I-want-to-make-more-forks-of-same-repo/MMS3_MCU_ESP32-C6/README.md

# MMS 3 ESP32 C6

## Project Status: **Ongoing**  
### Ver 1.0
**Design** ✅ — **Fabrication** ⏳ — **Assembly** ⏳ — **Bringup** ⏳ — **Testing** ⏳

Jak za 3 razem się udało, to za 4 też będzie git!

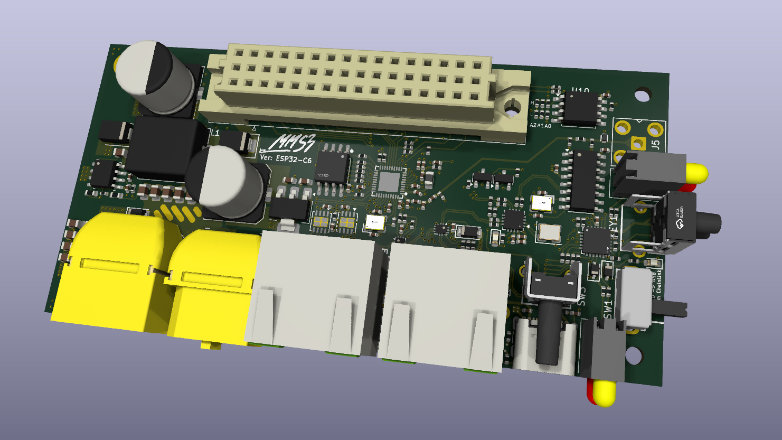
[picture p1: PCB_Picture.png]
Zdjęcie płytki
