I-want-to-make-more-forks-of-same-repo/MMS3_MCU_ESP32-C6/MMS3/MMS3_ESP32-C6.kicad_pcb

## KiCad design MMS3/MMS3_ESP32-C6.kicad_pcb (2026-10-02)

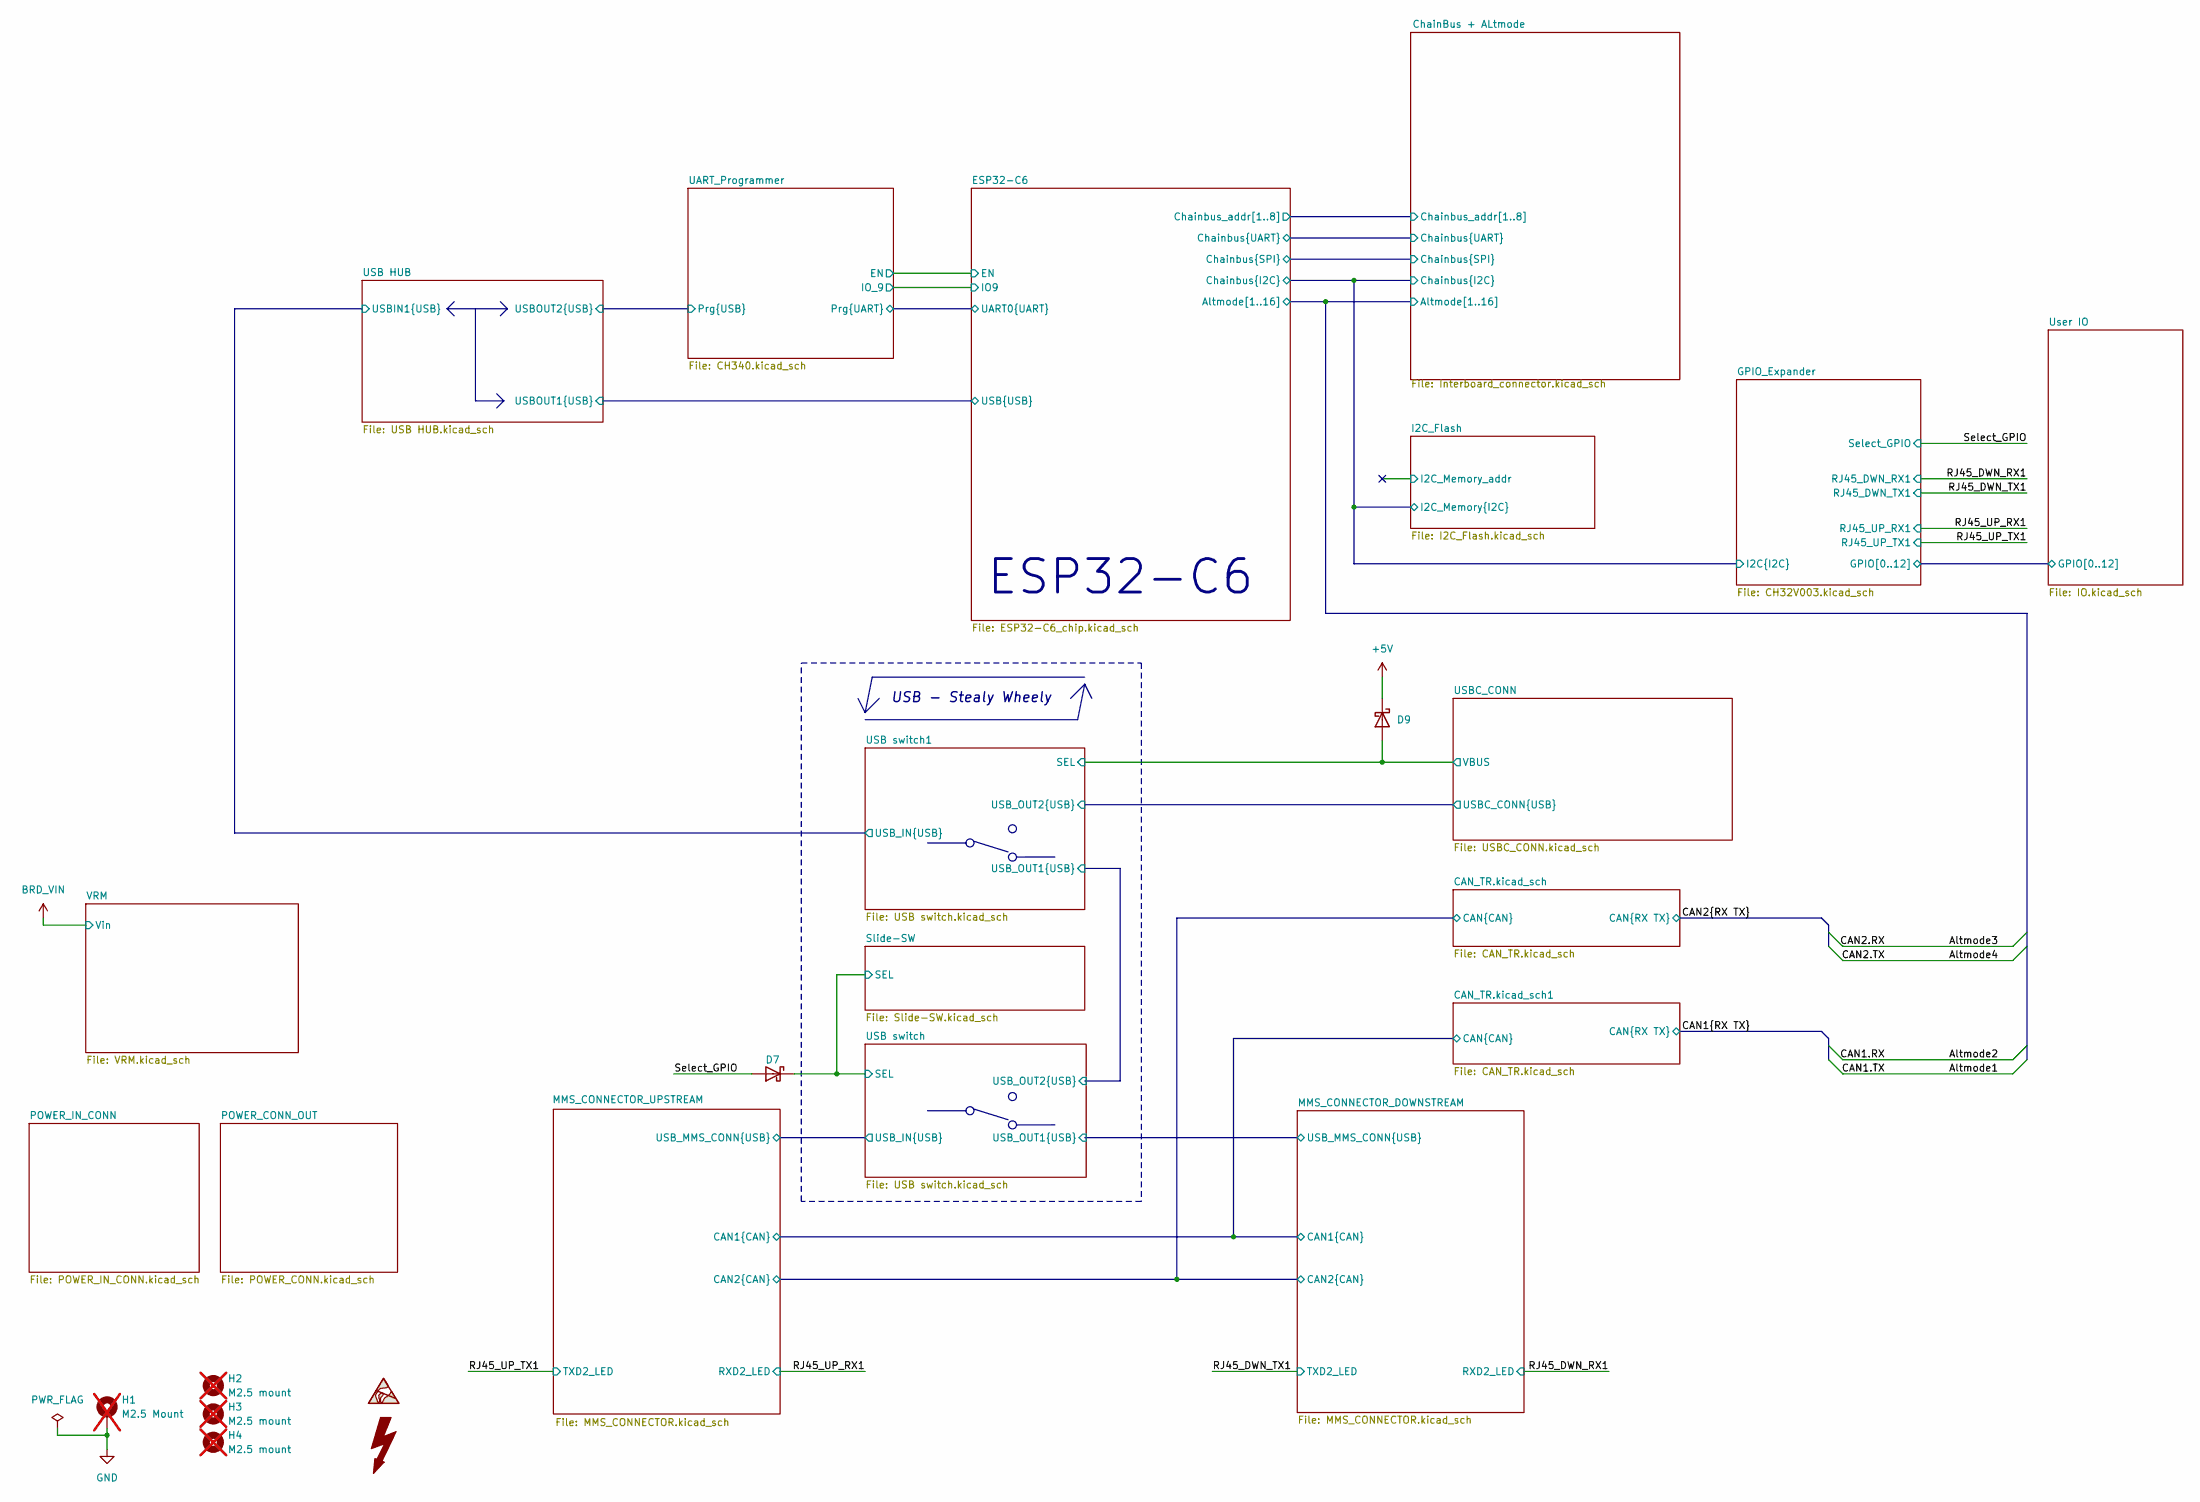
[picture p2: schematic MMS3_ESP32-C6.kicad_sch, MMS3 MCU ESP32-C6]

Parts:
D7, D9: 1N5819WS; D_SOD-323; Forward Voltage (Vf@If) 600mV@1A; Reverse Voltage (Vr) 40V; Part 1N5819WS; LCSC C191023
H1: M2.5 Mount; MountingHole_2.7mm_M2.5_DIN965_Pad_TopOnly; not fitted
H2, H3, H4: M2.5 mount; MountingHole_2.7mm_M2.5; not fitted

Connections:
+5V: D9.1; also elsewhere on the board
/Select_GPIO: D7.2; also elsewhere on the board
/Slide-SW/SEL: D7.1; also elsewhere on the board
/USBC_CONN/VBUS: D9.2; also elsewhere on the board
GND: H1.1 (1_1); also elsewhere on the board

Notes on the sheet:
USB - Stealy Wheely
ESP32-C6

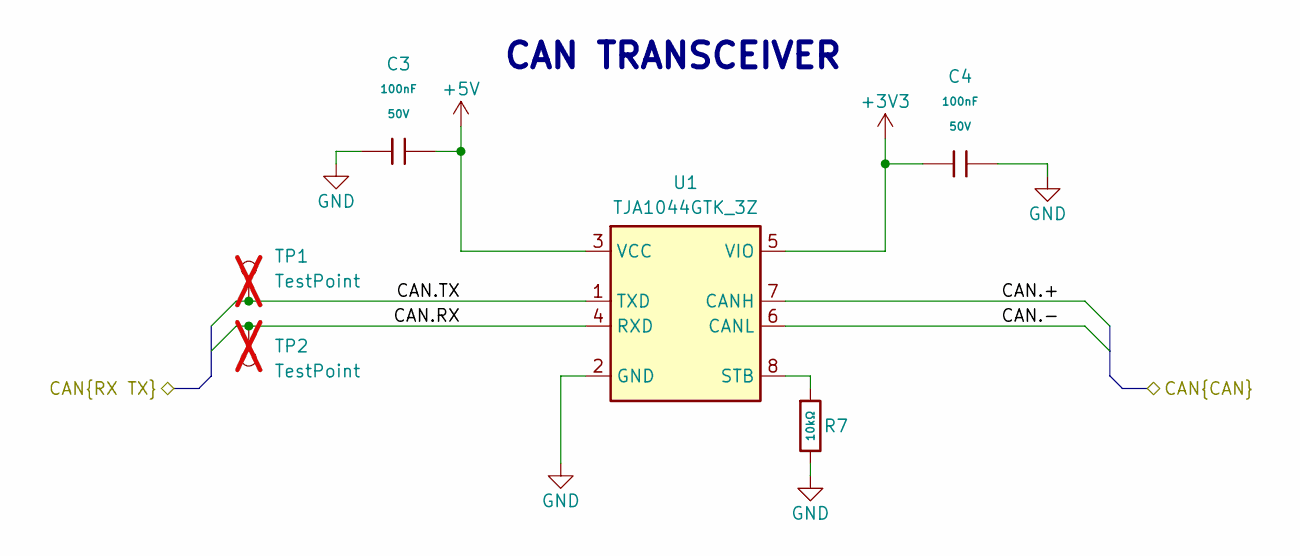
[picture p3: schematic CAN_TR.kicad_sch, MMS3 MCU ESP32-C6]

Parts:
C3, C4: 100nF; C_0402; Voltage Rated 50V; Tolerance ±10%; Part CL05B104KB54PNC; LCSC C307331
R7: 10kΩ; R_0402; Overload Voltage (Max) 50V; Tolerance ±1%; Part 0402WGF1002TCE; LCSC C25744
TP1, TP2: TestPoint; TestPoint_Pad_D1.0mm; not fitted
U1: TJA1044GTK_3Z; HVSON-8-1EP_3x3mm_P0.65mm_EP1.6x2.4mm; Manufacturer_Part_Number TJA1044GTK/3Z; LCSC C5215851

Connections:
+3V3: C4.1, U1.5 (VIO); also elsewhere on the board
+5V: C3.2, U1.3 (VCC); also elsewhere on the board
/CAN_TR.kicad_sch/CAN.+: U1.7 (CANH); also elsewhere on the board
/CAN_TR.kicad_sch/CAN.-: U1.6 (CANL); also elsewhere on the board
/ChainBus + ALtmode/Altmode3: TP2.1 (1_1), U1.4 (RXD); also elsewhere on the board
/ChainBus + ALtmode/Altmode4: TP1.1 (1_1), U1.1 (TXD); also elsewhere on the board
GND: C3.1, C4.2, R7.2, U1.2 (GND), U1.9 (EP); also elsewhere on the board
unnamed: R7.1, U1.8 (STB)

Parts of its further copies:
C6, C7: 100nF; C_0402; Voltage Rated 50V; Tolerance ±10%; Part CL05B104KB54PNC; LCSC C307331
R12: 10kΩ; R_0402; Overload Voltage (Max) 50V; Tolerance ±1%; Part 0402WGF1002TCE; LCSC C25744
TP3, TP4: TestPoint; TestPoint_Pad_D1.0mm; not fitted
U6: TJA1044GTK_3Z; HVSON-8-1EP_3x3mm_P0.65mm_EP1.6x2.4mm; Manufacturer_Part_Number TJA1044GTK/3Z; LCSC C5215851

Connections of its further copies:
+3V3: C7.1, U6.5 (VIO); also elsewhere on the board
+5V: C6.2, U6.3 (VCC); also elsewhere on the board
/CAN_TR.kicad_sch1/CAN.+: U6.7 (CANH); also elsewhere on the board
/CAN_TR.kicad_sch1/CAN.-: U6.6 (CANL); also elsewhere on the board
/ChainBus + ALtmode/Altmode1: TP3.1 (1_1), U6.1 (TXD); also elsewhere on the board
/ChainBus + ALtmode/Altmode2: TP4.1 (1_1), U6.4 (RXD); also elsewhere on the board
GND: C6.1, C7.2, R12.2, U6.2 (GND), U6.9 (EP); also elsewhere on the board
unnamed: R12.1, U6.8 (STB)

Notes on the sheet:
CAN TRANSCEIVER

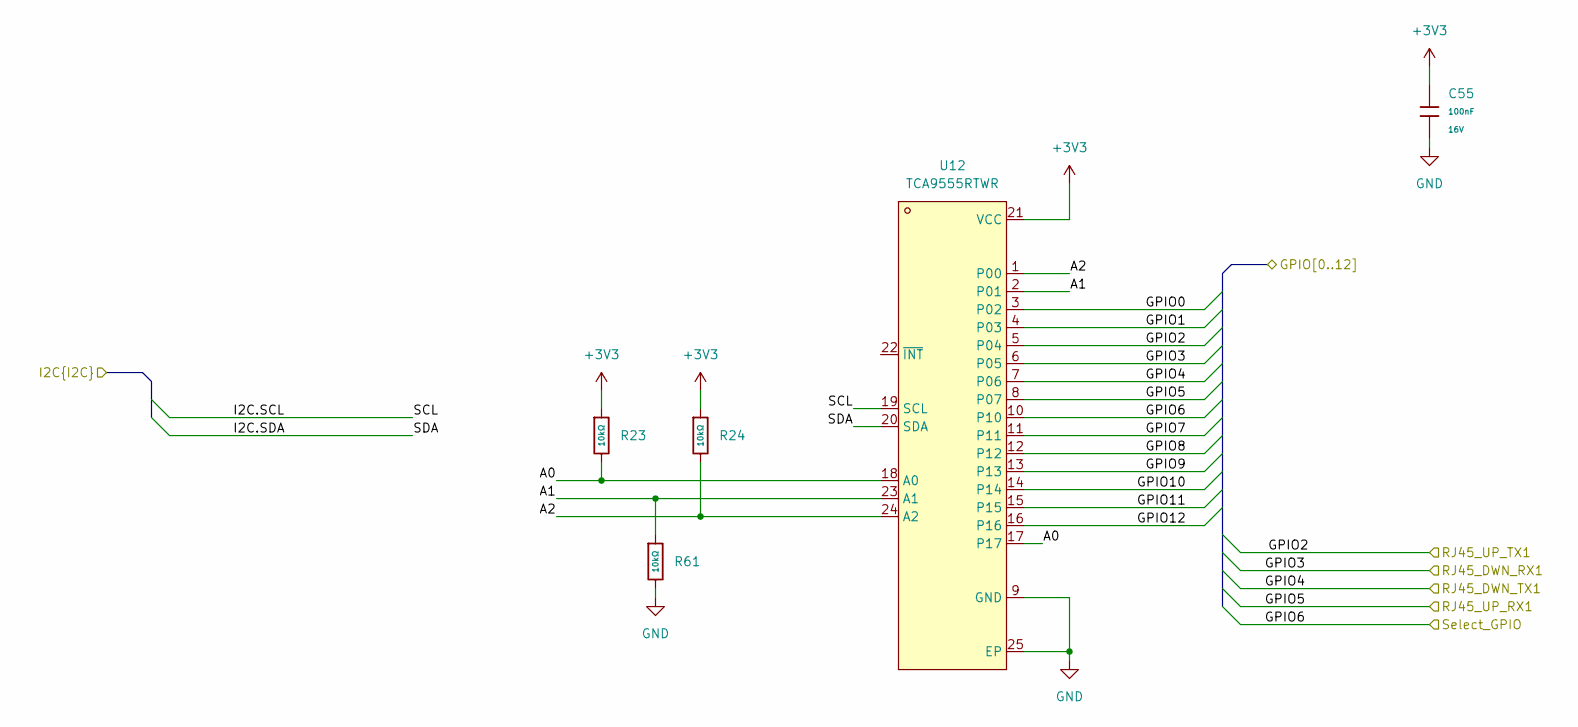
[picture p4: schematic CH32V003.kicad_sch, MMS3 Hat Meter/Source]

Parts:
C55: 100nF; C_0402; Voltage Rated 16V; Tolerance ±10%; Part CL05B104KO5NNNC; LCSC C1525
R23, R24, R61: 10kΩ; R_0402; Overload Voltage (Max) 50V; Tolerance ±1%; Part 0402WGF1002TCE; LCSC C25744
U12: TCA9555RTWR; HVQFN-24_L4.0-W4.0-P0.50-BL-EP2.6; MPN TCA9555RTWR(UMW); LCSC Part C42420609

Connections:
+3V3: C55.1, R23.1, R24.1, U12.21 (VCC); also elsewhere on the board
/ChainBus + ALtmode/Chainbus.SCL: U12.19 (SCL); also elsewhere on the board
/ChainBus + ALtmode/Chainbus.SDA: U12.20 (SDA); also elsewhere on the board
/GPIO_Expander/A0: R23.2, U12.17, U12.18 (A0)
/GPIO_Expander/A1: R61.1, U12.2 (P01), U12.23 (A1)
/GPIO_Expander/A2: R24.2, U12.1 (P00), U12.24 (A2)
/GPIO_Expander/GPIO0: U12.3 (P02); also elsewhere on the board
/GPIO_Expander/GPIO1: U12.4 (P03); also elsewhere on the board
/GPIO_Expander/GPIO7: U12.11
/GPIO_Expander/GPIO8: U12.12; also elsewhere on the board
/GPIO_Expander/GPIO9: U12.13; also elsewhere on the board
/GPIO_Expander/GPIO10: U12.14; also elsewhere on the board
/GPIO_Expander/GPIO11: U12.15
/GPIO_Expander/GPIO12: U12.16
/RJ45_DWN_RX1: U12.6 (P05); also elsewhere on the board
/RJ45_DWN_TX1: U12.7 (P06); also elsewhere on the board
/RJ45_UP_RX1: U12.8 (P07); also elsewhere on the board
/RJ45_UP_TX1: U12.5 (P04); also elsewhere on the board
/Select_GPIO: U12.10; also elsewhere on the board
GND: C55.2, R61.2, U12.9 (GND), U12.25 (EP); also elsewhere on the board

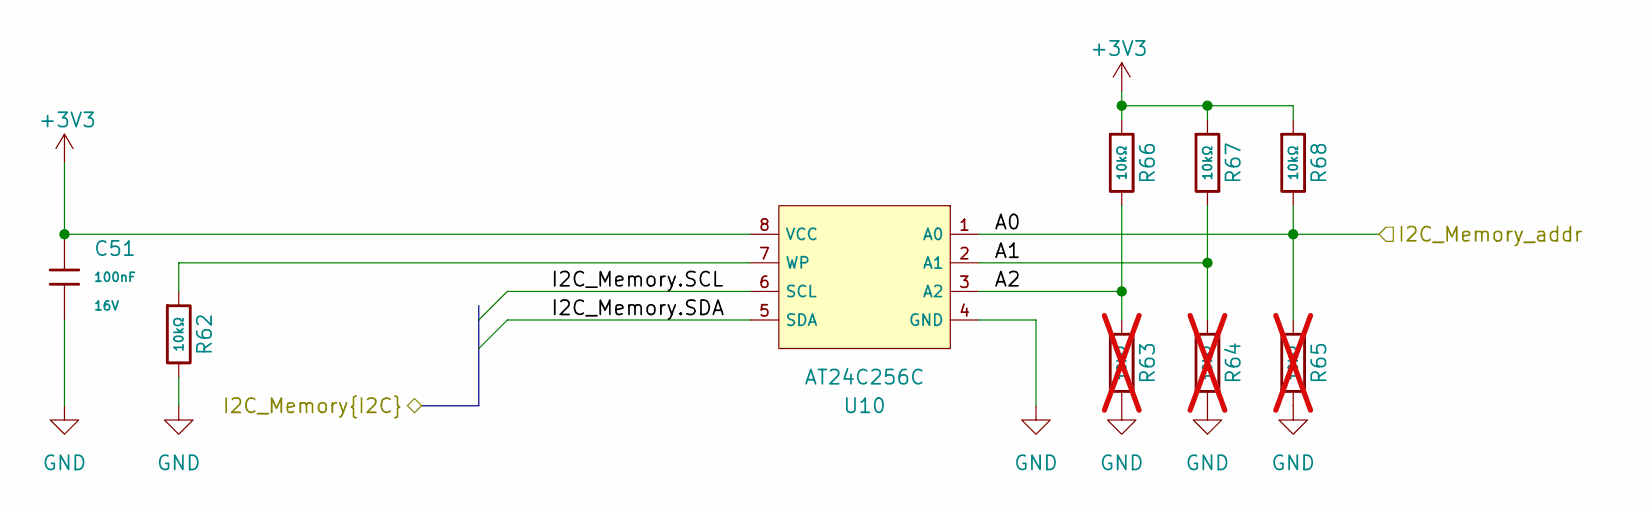
[picture p5: schematic I2C_Flash.kicad_sch, MMS3 MCU ESP32-C6]

Parts:
C51: 100nF; C_0402; Voltage Rated 16V; Tolerance ±10%; Part CL05B104KO5NNNC; LCSC C1525
R62, R66, R67, R68: 10kΩ; R_0402; Overload Voltage (Max) 50V; Tolerance ±1%; Part 0402WGF1002TCE; LCSC C25744
R63, R64, R65: 10kΩ; R_0402; Overload Voltage (Max) 50V; Tolerance ±1%; Part 0402WGF1002TCE; LCSC C25744; not fitted
U10: AT24C256C; SOIC-8_5.3x5.3mm_P1.27mm; Supply Voltage 1.7V~5.5V; Part AT24C256C-SSHL-T; LCSC C6482

Connections:
+3V3: C51.1, R66.1, R67.1, R68.1, U10.8 (VCC); also elsewhere on the board
/ChainBus + ALtmode/Chainbus.SCL: U10.6 (SCL); also elsewhere on the board
/ChainBus + ALtmode/Chainbus.SDA: U10.5 (SDA); also elsewhere on the board
/I2C_Flash/A0: R65.1, R68.2, U10.1 (A0)
/I2C_Flash/A1: R64.1, R67.2, U10.2 (A1)
/I2C_Flash/A2: R63.1, R66.2, U10.3 (A2)
GND: C51.2, R62.2, R63.2, R64.2, R65.2, U10.4 (GND); also elsewhere on the board
unnamed: R62.1, U10.7 (WP)

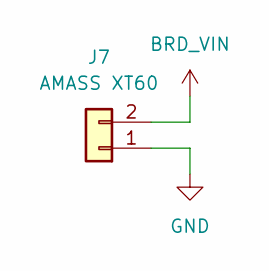
[picture p6: schematic POWER_CONN.kicad_sch, MMS3 MCU ESP32-C6]

Parts:
J7: AMASS XT60; AMASS_XT60PW-F_1x02_P7.20mm_Horizontal; LCSC C428722

Connections:
BRD_VIN: J7.2; also elsewhere on the board
GND: J7.1; also elsewhere on the board

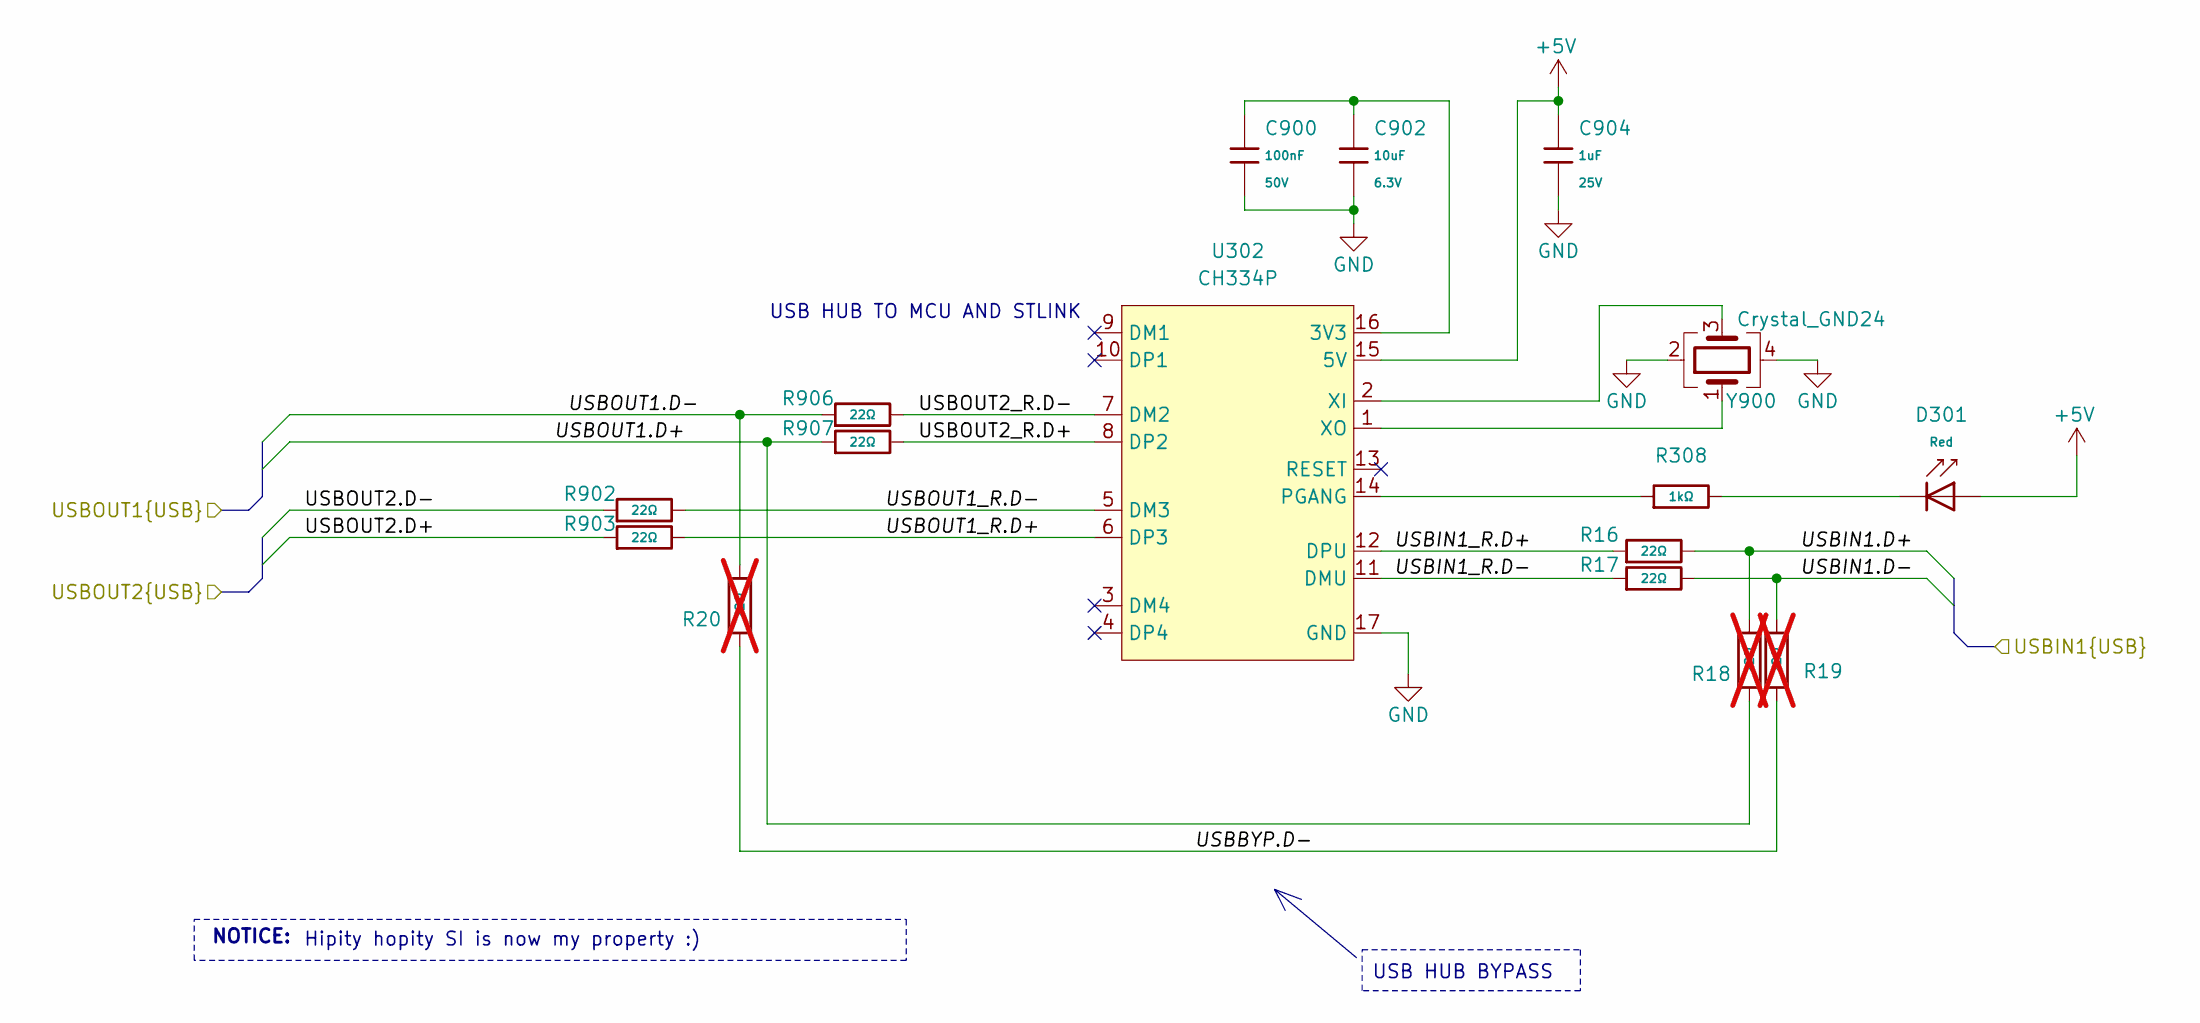
[picture p7: schematic USB HUB.kicad_sch, MMS3 MCU ESP32-C6]

Parts:
C900: 100nF; C_0402; Voltage Rated 50V; Tolerance ±10%; Part CL05B104KB54PNC; LCSC C307331
C902: 10uF; C_0402; Voltage Rated 6.3V; Tolerance ±20%; Part CL05A106MQ5NUNC; LCSC C15525
C904: 1uF; C_0402; Voltage Rated 25V; Tolerance ±10%; Part CL05A105KA5NQNC; LCSC C52923
D301: Red; D_0603; Part KT-0603R; LCSC C2286
R16, R17, R902, R903, R906, R907: 22Ω; R_0402; Overload Voltage (Max) 50V; Tolerance ±1%; Part 0402WGF220JTCE; LCSC C25092
R18, R19, R20: 22Ω; R_0402; Overload Voltage (Max) 50V; Tolerance ±1%; Part 0402WGF220JTCE; LCSC C25092; not fitted
R308: 1kΩ; R_0402; Overload Voltage (Max) 50V; Tolerance ±1%; Part 0402WGF1001TCE; LCSC C11702
U302: CH334P; QFN-16-1EP_3x3mm_P0.5mm_EP1.7x1.7mm; LCSC C5373042
Y900: Crystal_GND24; Crystal_SMD_3225-4Pin_3.2x2.5mm; LCSC C9002

Connections:
+5V: C904.1, D301.2, U302.15 (5V); also elsewhere on the board
/ESP32-C6/USB.D+: R18.1, R907.1; also elsewhere on the board
/ESP32-C6/USB.D-: R20.2, R906.1; also elsewhere on the board
/UART_Programmer/Prg.D+: R903.1; also elsewhere on the board
/UART_Programmer/Prg.D-: R902.1; also elsewhere on the board
/USB HUB/USBBYP.D-: R19.1, R20.1
/USB HUB/USBIN1.D+: R16.2, R18.2; also elsewhere on the board
/USB HUB/USBIN1.D-: R17.2, R19.2; also elsewhere on the board
/USB HUB/USBIN1_R.D+: R16.1, U302.12 (DPU)
/USB HUB/USBIN1_R.D-: R17.1, U302.11 (DMU)
/USB HUB/USBOUT1_R.D+: R903.2, U302.6 (DP3)
/USB HUB/USBOUT1_R.D-: R902.2, U302.5 (DM3)
/USB HUB/USBOUT2_R.D+: R907.2, U302.8 (DP2)
/USB HUB/USBOUT2_R.D-: R906.2, U302.7 (DM2)
GND: C900.2, C902.2, C904.2, U302.17 (GND), Y900.2, Y900.4; also elsewhere on the board
unnamed: D301.1, R308.2
unnamed: C900.1, C902.1, U302.16 (3V3)
unnamed: R308.1, U302.14 (PGANG)
unnamed: U302.2 (XI), Y900.3
unnamed: U302.1 (XO), Y900.1

Notes on the sheet:
NOTICE:
Hipity hopity SI is now my property :)
USB HUB TO MCU AND STLINK
USB HUB BYPASS

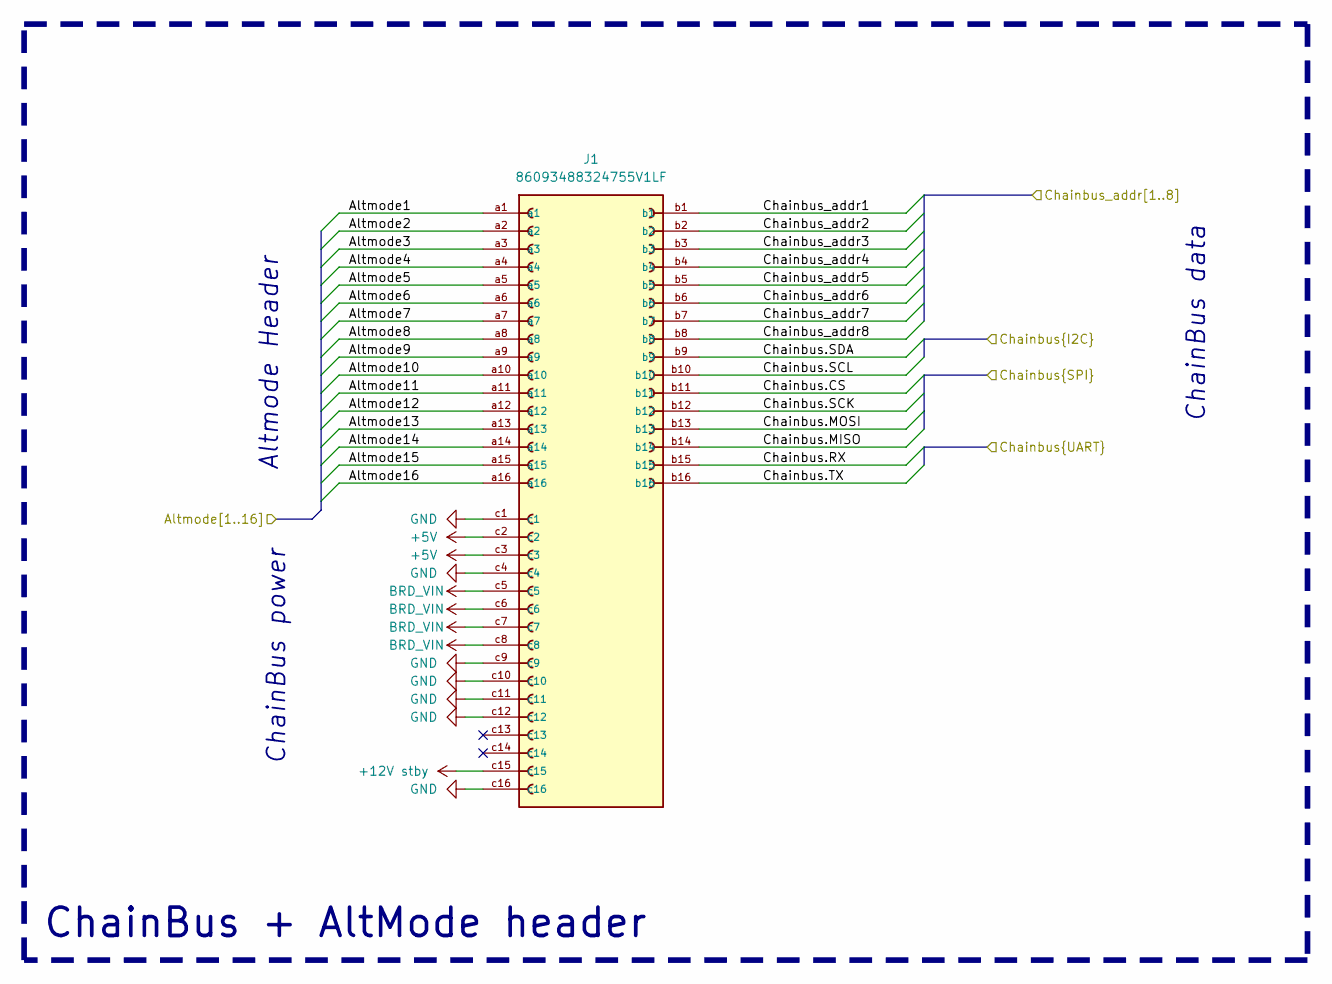
[picture p8: schematic Interboard_connector.kicad_sch, MMS3 MCU ESP32-C6]

Parts:
J1: 86093488324755V1LF; DIN41612_C2_3x16_Female_Vertical_THT; PARTREV C; LCSC C5173373

Connections:
+5V: J1.c2, J1.c3; also elsewhere on the board
+12V stby: J1.c15; also elsewhere on the board
/ChainBus + ALtmode/Altmode1: J1.a1; also elsewhere on the board
/ChainBus + ALtmode/Altmode2: J1.a2; also elsewhere on the board
/ChainBus + ALtmode/Altmode3: J1.a3; also elsewhere on the board
/ChainBus + ALtmode/Altmode4: J1.a4; also elsewhere on the board
/ChainBus + ALtmode/Altmode5: J1.a5
/ChainBus + ALtmode/Altmode6: J1.a6
/ChainBus + ALtmode/Altmode7: J1.a7
/ChainBus + ALtmode/Altmode8: J1.a8
/ChainBus + ALtmode/Altmode9: J1.a9
/ChainBus + ALtmode/Altmode10: J1.a10
/ChainBus + ALtmode/Altmode11: J1.a11
/ChainBus + ALtmode/Altmode12: J1.a12
/ChainBus + ALtmode/Altmode13: J1.a13
/ChainBus + ALtmode/Altmode14: J1.a14
/ChainBus + ALtmode/Altmode15: J1.a15
/ChainBus + ALtmode/Altmode16: J1.a16
/ChainBus + ALtmode/Chainbus.CS: J1.b11; also elsewhere on the board
/ChainBus + ALtmode/Chainbus.MISO: J1.b14; also elsewhere on the board
/ChainBus + ALtmode/Chainbus.MOSI: J1.b13; also elsewhere on the board
/ChainBus + ALtmode/Chainbus.RX: J1.b15; also elsewhere on the board
/ChainBus + ALtmode/Chainbus.SCK: J1.b12; also elsewhere on the board
/ChainBus + ALtmode/Chainbus.SCL: J1.b10; also elsewhere on the board
/ChainBus + ALtmode/Chainbus.SDA: J1.b9; also elsewhere on the board
/ChainBus + ALtmode/Chainbus.TX: J1.b16; also elsewhere on the board
/ChainBus + ALtmode/Chainbus_addr1: J1.b1; also elsewhere on the board
/ChainBus + ALtmode/Chainbus_addr2: J1.b2; also elsewhere on the board
/ChainBus + ALtmode/Chainbus_addr3: J1.b3; also elsewhere on the board
/ChainBus + ALtmode/Chainbus_addr4: J1.b4; also elsewhere on the board
/ChainBus + ALtmode/Chainbus_addr5: J1.b5; also elsewhere on the board
/ChainBus + ALtmode/Chainbus_addr6: J1.b6; also elsewhere on the board
/ChainBus + ALtmode/Chainbus_addr7: J1.b7; also elsewhere on the board
/ChainBus + ALtmode/Chainbus_addr8: J1.b8; also elsewhere on the board
BRD_VIN: J1.c5, J1.c6, J1.c7, J1.c8; also elsewhere on the board
GND: J1.c1, J1.c4, J1.c9, J1.c10, J1.c11, J1.c12, J1.c16; also elsewhere on the board

Notes on the sheet:
ChainBus data
ChainBus power
Altmode Header
ChainBus + AltMode header

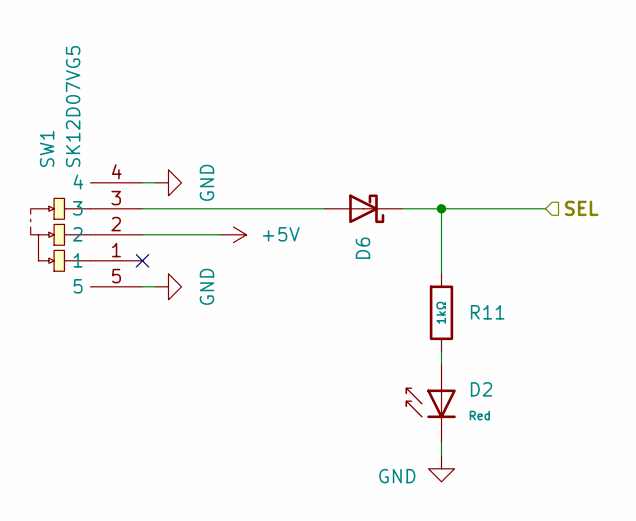
[picture p9: schematic Slide-SW.kicad_sch, MMS3 MCU ESP32-C6]

Parts:
D2: Red; D_0603; Part KT-0603R; LCSC C2286
D6: 1N5819WS; D_SOD-323; Forward Voltage (Vf@If) 600mV@1A; Reverse Voltage (Vr) 40V; Part 1N5819WS; LCSC C191023
R11: 1kΩ; R_0402; Overload Voltage (Max) 50V; Tolerance ±1%; Part 0402WGF1001TCE; LCSC C11702
SW1: SK12D07VG5; SW-TH_SK12D07VG5-1; MPN SK12D07VG5; LCSC Part C431548

Connections:
+5V: SW1.2; also elsewhere on the board
/Slide-SW/SEL: D6.1, R11.1; also elsewhere on the board
GND: D2.1, SW1.4, SW1.5; also elsewhere on the board
unnamed: D2.2, R11.2
unnamed: D6.2, SW1.3

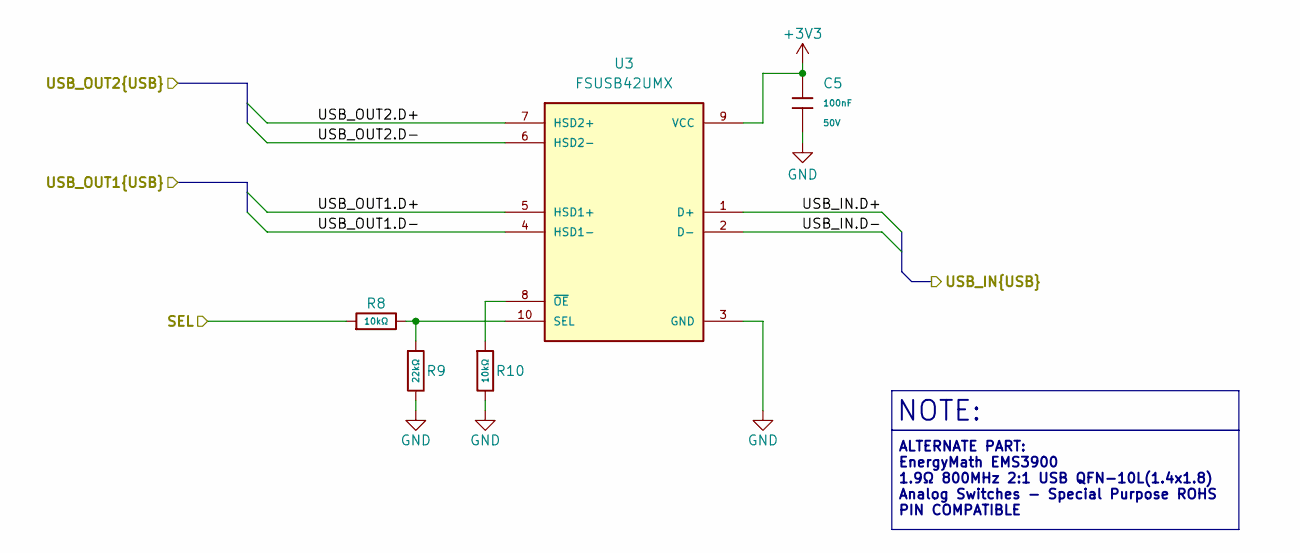
[picture p10: schematic USB switch.kicad_sch, MMS3 MCU ESP32-C6]

Parts:
C5: 100nF; C_0402; Voltage Rated 50V; Tolerance ±10%; Part CL05B104KB54PNC; LCSC C307331
R8, R10: 10kΩ; R_0402; Overload Voltage (Max) 50V; Tolerance ±1%; Part 0402WGF1002TCE; LCSC C25744
R9: 22kΩ; R_0402; Overload Voltage (Max) 50V; Tolerance ±1%; Part 0402WGF2202TCE; LCSC C25768
U3: FSUSB42UMX; UQFN-10_1.4x1.8mm_P0.4mm; PARTREV 1.25; LCSC C11145

Connections:
+3V3: C5.1, U3.9 (VCC); also elsewhere on the board
/MMS_CONNECTOR_DOWNSTREAM/USB_MMS_CONN.D+: U3.5 (HSD1+); also elsewhere on the board
/MMS_CONNECTOR_DOWNSTREAM/USB_MMS_CONN.D-: U3.4 (HSD1-); also elsewhere on the board
/MMS_CONNECTOR_UPSTREAM/USB_MMS_CONN.D+: U3.1 (D+); also elsewhere on the board
/MMS_CONNECTOR_UPSTREAM/USB_MMS_CONN.D-: U3.2 (D-); also elsewhere on the board
/Slide-SW/SEL: R8.1; also elsewhere on the board
/USB switch/USB_OUT2.D+: U3.7 (HSD2+); also elsewhere on the board
/USB switch/USB_OUT2.D-: U3.6 (HSD2-); also elsewhere on the board
GND: C5.2, R9.2, R10.2, U3.3 (GND); also elsewhere on the board
unnamed: R8.2, R9.1, U3.10 (SEL)
unnamed: R10.1, U3.8 (~OE)

Parts of its further copies:
C8: 100nF; C_0402; Voltage Rated 50V; Tolerance ±10%; Part CL05B104KB54PNC; LCSC C307331
R13, R15: 10kΩ; R_0402; Overload Voltage (Max) 50V; Tolerance ±1%; Part 0402WGF1002TCE; LCSC C25744
R14: 22kΩ; R_0402; Overload Voltage (Max) 50V; Tolerance ±1%; Part 0402WGF2202TCE; LCSC C25768
U7: FSUSB42UMX; UQFN-10_1.4x1.8mm_P0.4mm; PARTREV 1.25; LCSC C11145

Connections of its further copies:
+3V3: C8.1, U7.9 (VCC); also elsewhere on the board
/USB HUB/USBIN1.D+: U7.1 (D+); also elsewhere on the board
/USB HUB/USBIN1.D-: U7.2 (D-); also elsewhere on the board
/USB switch1/USB_OUT2.D+: U7.7 (HSD2+); also elsewhere on the board
/USB switch1/USB_OUT2.D-: U7.6 (HSD2-); also elsewhere on the board
/USB switch/USB_OUT2.D+: U7.5 (HSD1+); also elsewhere on the board
/USB switch/USB_OUT2.D-: U7.4 (HSD1-); also elsewhere on the board
/USBC_CONN/VBUS: R13.1; also elsewhere on the board
GND: C8.2, R14.2, R15.2, U7.3 (GND); also elsewhere on the board
unnamed: R13.2, R14.1, U7.10 (SEL)
unnamed: R15.1, U7.8 (~OE)

Notes on the sheet:
ALTERNATE PART: EnergyMath EMS3900 1.9Ω 800MHz 2:1 USB QFN-10L(1.4x1.8) Analog Switches - Special Purpose ROHS PIN COMPATIBLE
NOTE:

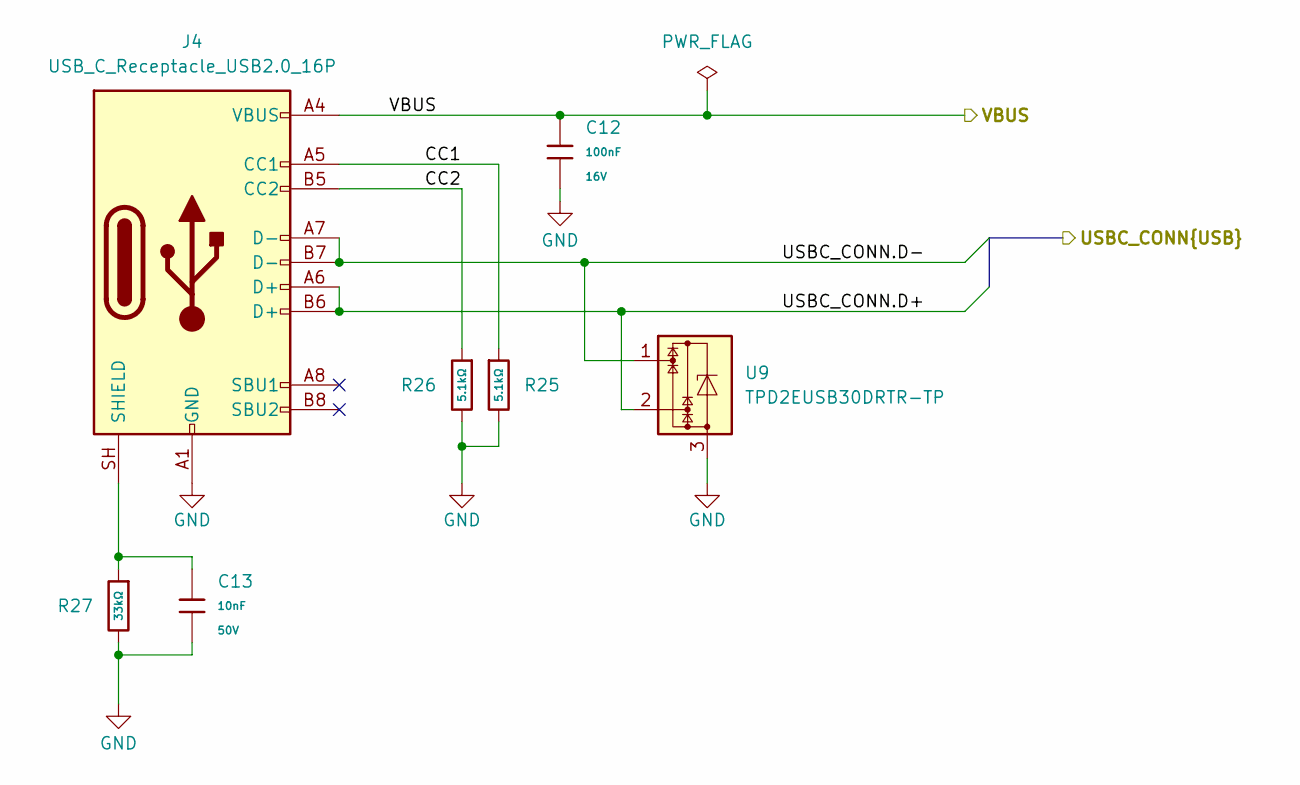
[picture p11: schematic USBC_CONN.kicad_sch, MMS3 MCU ESP32-C6]

Parts:
C12: 100nF; C_0402; Voltage Rated 16V; Tolerance ±10%; Part CL05B104KO5NNNC; LCSC C1525
C13: 10nF; C_0402; Voltage Rated 50V; Tolerance ±10%; Part CL05B103KB5NNNC; LCSC C15195
J4: USB_C_Receptacle_USB2.0_16P; USB_C_Receptacle_GCT_USB4105-xx-A_16P_TopMnt_Horizontal; LCSC C165948
R25, R26: 5.1kΩ; R_0402; Overload Voltage (Max) 50V; Tolerance ±1%; Part 0402WGF5101TCE; LCSC C25905
R27: 33kΩ; R_0402; Overload Voltage (Max) 50V; Tolerance ±1%; Part 0402WGF3302TCE; LCSC C25779
U9: TPD2EUSB30DRTR-TP; SOT-723; LCSC C2844720

Connections:
/USB switch1/USB_OUT2.D+: J4.A6 (D+), J4.B6 (D+), U9.2; also elsewhere on the board
/USB switch1/USB_OUT2.D-: J4.A7 (D-), J4.B7 (D-), U9.1; also elsewhere on the board
/USBC_CONN/CC1: J4.A5 (CC1), R25.1
/USBC_CONN/CC2: J4.B5 (CC2), R26.1
/USBC_CONN/VBUS: C12.1, J4.A4 (VBUS), J4.A9 (VBUS), J4.B4 (VBUS), J4.B9 (VBUS); also elsewhere on the board
GND: C12.2, C13.2, J4.A1 (GND), J4.A12 (GND), J4.B1 (GND), J4.B12 (GND), R25.2, R26.2, R27.2, U9.3; also elsewhere on the board
unnamed: C13.1, J4.SH (SHIELD), R27.1

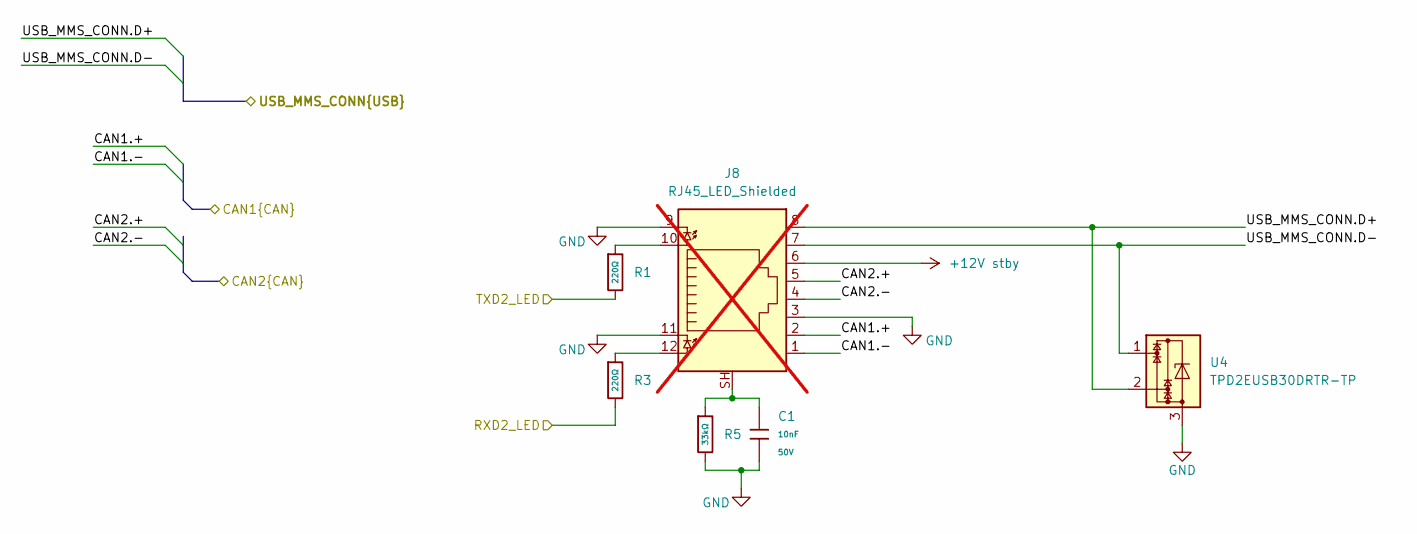
[picture p12: schematic MMS_CONNECTOR.kicad_sch, MMS3 MCU ESP32-C6]

Parts:
C1: 10nF; C_0402; Voltage Rated 50V; Tolerance ±10%; Part CL05B103KB5NNNC; LCSC C15195
J8: RJ45_LED_Shielded; RJ45_Amphenol_RJHSE538X; LCSC C7501824; not fitted
R1, R3: 220Ω; R_0402; Overload Voltage (Max) 50V; Tolerance ±1%; Part 0402WGF2200TCE; LCSC C25091
R5: 33kΩ; R_0402; Overload Voltage (Max) 50V; Tolerance ±1%; Part 0402WGF3302TCE; LCSC C25779
U4: TPD2EUSB30DRTR-TP; SOT-723; LCSC C2844720

Connections:
+12V stby: J8.6; also elsewhere on the board
/CAN_TR.kicad_sch1/CAN.+: J8.2; also elsewhere on the board
/CAN_TR.kicad_sch1/CAN.-: J8.1; also elsewhere on the board
/CAN_TR.kicad_sch/CAN.+: J8.5; also elsewhere on the board
/CAN_TR.kicad_sch/CAN.-: J8.4; also elsewhere on the board
/MMS_CONNECTOR_DOWNSTREAM/USB_MMS_CONN.D+: J8.8, U4.2; also elsewhere on the board
/MMS_CONNECTOR_DOWNSTREAM/USB_MMS_CONN.D-: J8.7, U4.1; also elsewhere on the board
/RJ45_DWN_RX1: R3.2; also elsewhere on the board
/RJ45_DWN_TX1: R1.2; also elsewhere on the board
GND: C1.2, J8.3, J8.9, J8.11, R5.2, U4.3; also elsewhere on the board
unnamed: C1.1, J8.SH, R5.1
unnamed: J8.10, R1.1
unnamed: J8.12, R3.1

Parts of its further copies:
C2: 10nF; C_0402; Voltage Rated 50V; Tolerance ±10%; Part CL05B103KB5NNNC; LCSC C15195
J9: RJ45_LED_Shielded; RJ45_Amphenol_RJHSE538X; LCSC C7501824; not fitted
R2, R4: 220Ω; R_0402; Overload Voltage (Max) 50V; Tolerance ±1%; Part 0402WGF2200TCE; LCSC C25091
R6: 33kΩ; R_0402; Overload Voltage (Max) 50V; Tolerance ±1%; Part 0402WGF3302TCE; LCSC C25779
U5: TPD2EUSB30DRTR-TP; SOT-723; LCSC C2844720

Connections of its further copies:
+12V stby: J9.6; also elsewhere on the board
/CAN_TR.kicad_sch1/CAN.+: J9.2; also elsewhere on the board
/CAN_TR.kicad_sch1/CAN.-: J9.1; also elsewhere on the board
/CAN_TR.kicad_sch/CAN.+: J9.5; also elsewhere on the board
/CAN_TR.kicad_sch/CAN.-: J9.4; also elsewhere on the board
/MMS_CONNECTOR_UPSTREAM/USB_MMS_CONN.D+: J9.8, U5.2; also elsewhere on the board
/MMS_CONNECTOR_UPSTREAM/USB_MMS_CONN.D-: J9.7, U5.1; also elsewhere on the board
/RJ45_UP_RX1: R4.2; also elsewhere on the board
/RJ45_UP_TX1: R2.2; also elsewhere on the board
GND: C2.2, J9.3, J9.9, J9.11, R6.2, U5.3; also elsewhere on the board
unnamed: C2.1, J9.SH, R6.1
unnamed: J9.10, R2.1
unnamed: J9.12, R4.1
