I-want-to-make-more-forks-of-same-repo/MMS3_MCU_ESP32-C6/MMS3/MMS3_ESP32-C6.kicad_pcb

## KiCad design MMS3/MMS3_ESP32-C6.kicad_pcb (continued)

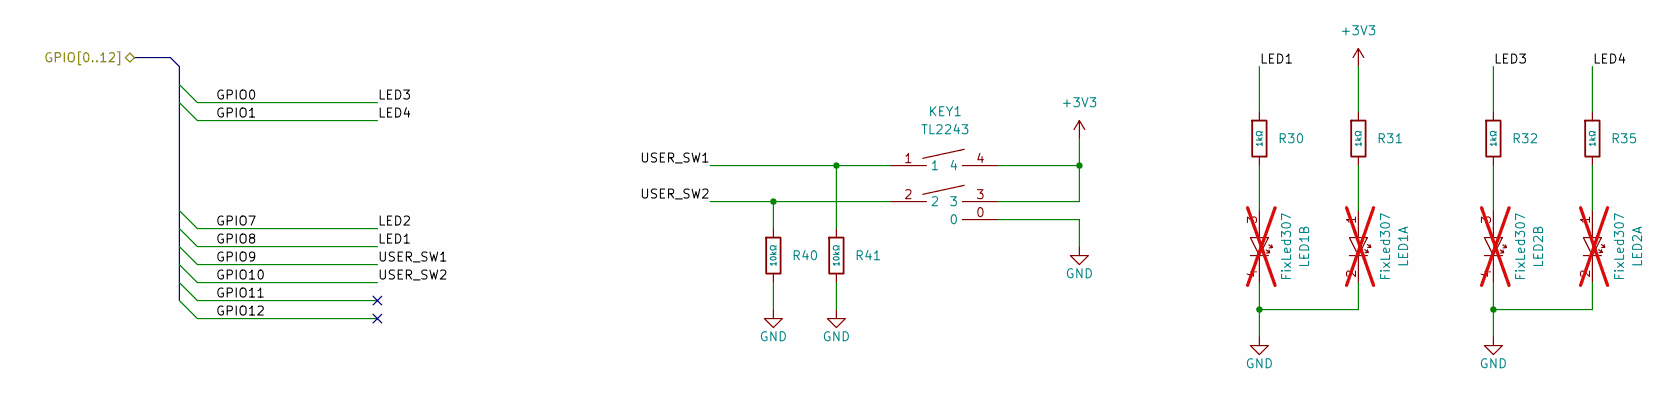
[picture p13: schematic IO.kicad_sch]

Parts:
KEY1: TL2243; KEY-TH_TL2243; MPN TL2243; LCSC Part C273515
LED1, LED2: FixLed307; not fitted
R30, R31, R32, R35: 1kΩ; R_0402; Overload Voltage (Max) 50V; Tolerance ±1%; Part 0402WGF1001TCE; LCSC C11702
R40, R41: 10kΩ; R_0402; Overload Voltage (Max) 50V; Tolerance ±1%; Part 0402WGF1002TCE; LCSC C25744

Connections:
+3V3: KEY1.3, KEY1.4, R31.1; also elsewhere on the board
/GPIO_Expander/GPIO0: R32.1; also elsewhere on the board
/GPIO_Expander/GPIO1: R35.1; also elsewhere on the board
/GPIO_Expander/GPIO8: R30.1; also elsewhere on the board
/GPIO_Expander/GPIO9: KEY1.1, R41.1; also elsewhere on the board
/GPIO_Expander/GPIO10: KEY1.2, R40.1; also elsewhere on the board
GND: KEY1.0, LED1.2, LED1.4, LED2.2, LED2.4, R40.2, R41.2; also elsewhere on the board
unnamed: LED1.1, R31.2
unnamed: LED1.3, R30.2
unnamed: LED2.1, R35.2
unnamed: LED2.3, R32.2

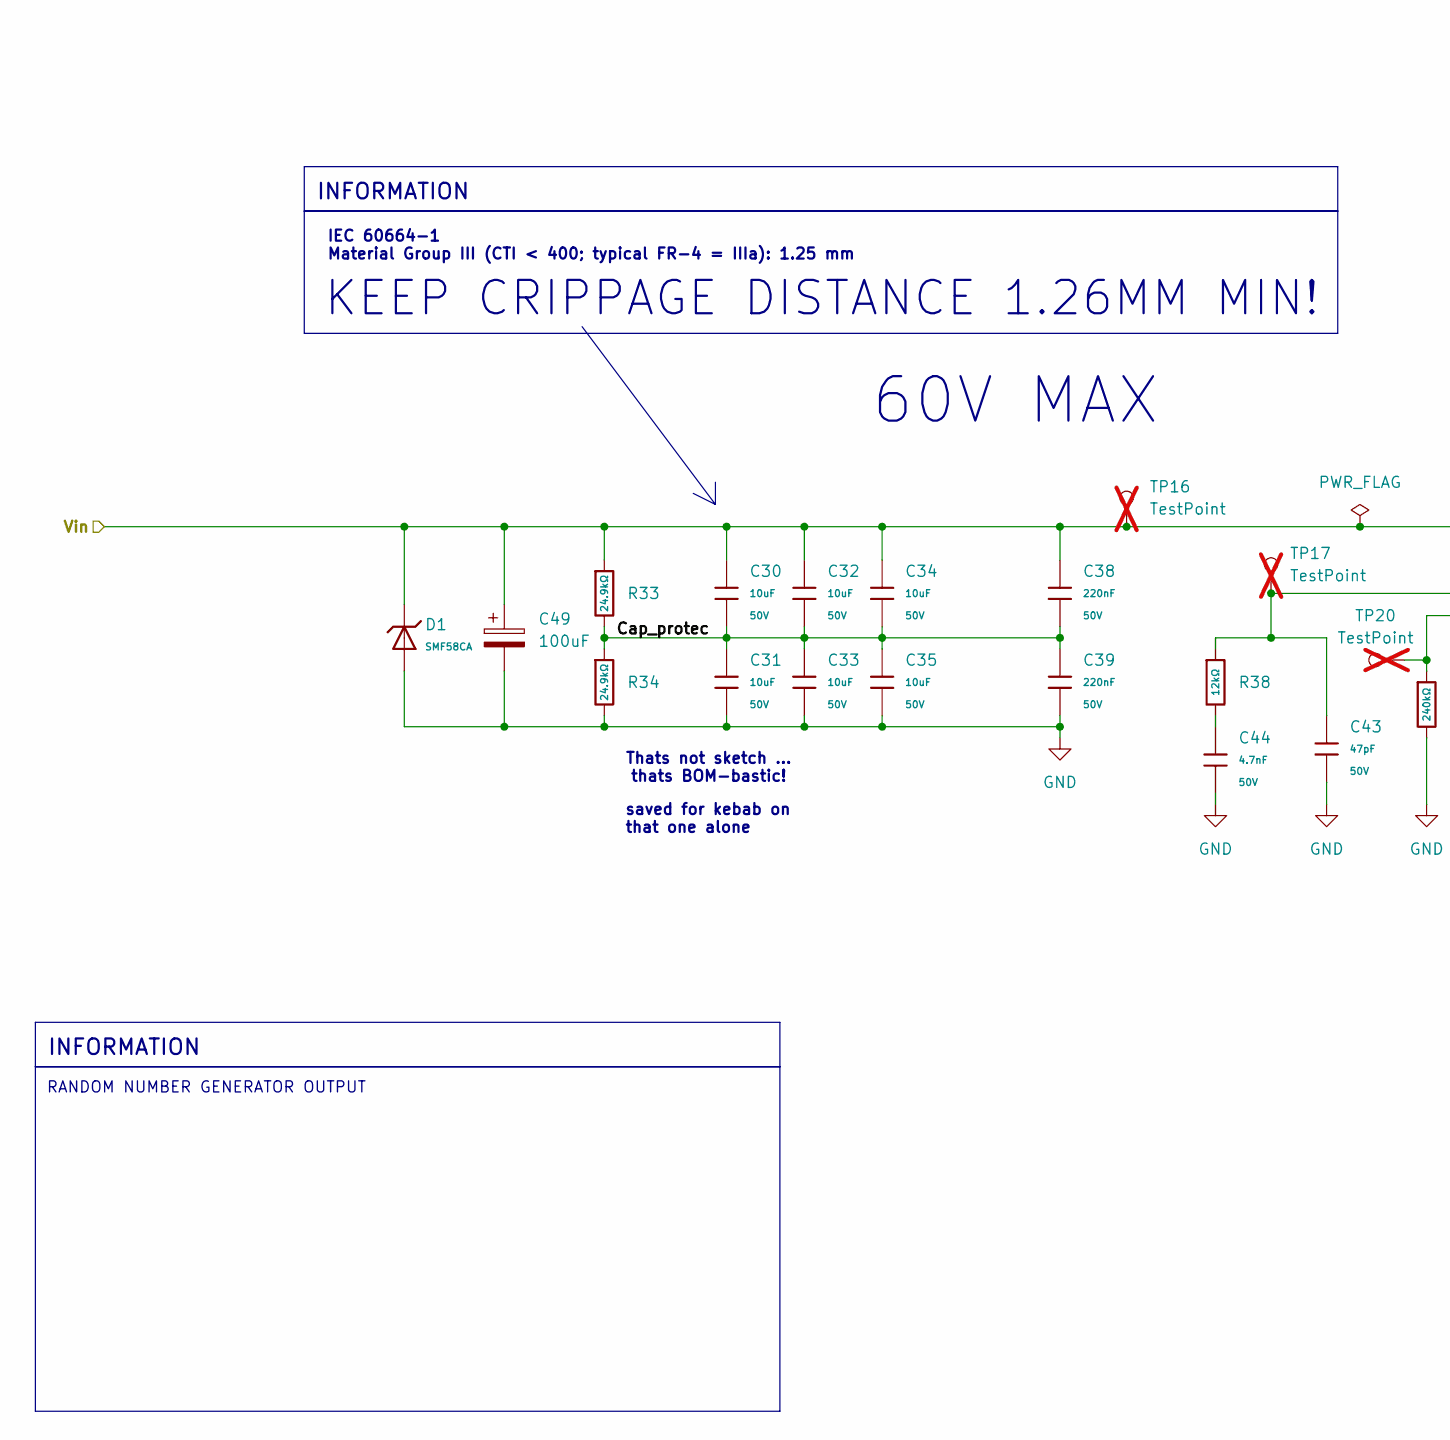
[picture p14: schematic VRM.kicad_sch, MMS3 MCU ESP32-C6, part in row 1, column 1]

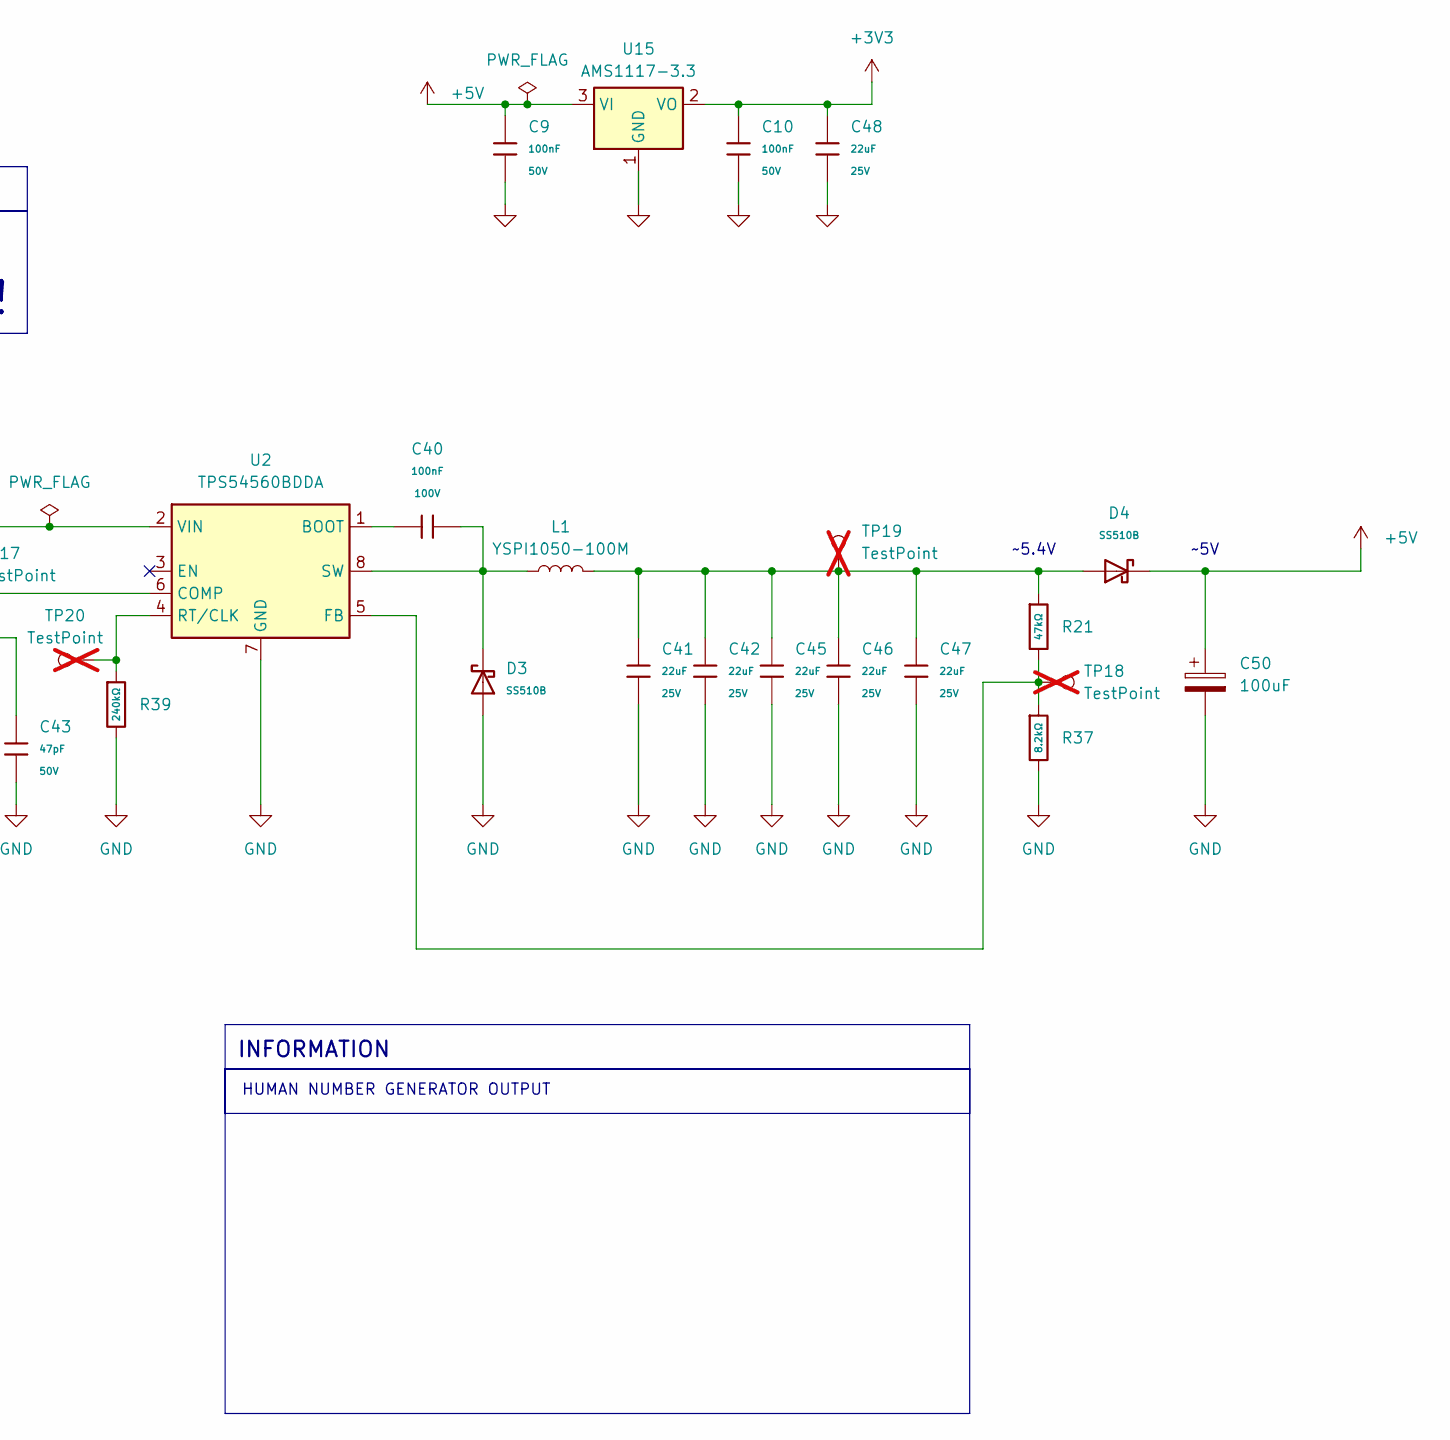
[picture p15: schematic VRM.kicad_sch, MMS3 MCU ESP32-C6, part in row 1, column 2]

Parts:
C9, C10: 100nF; C_0603; Voltage Rated 50V; Tolerance ±10%; Part CC0603KRX7R9BB104; LCSC C14663
C30, C31, C32, C33, C34, C35: 10uF; C_0805; Voltage Rated 50V; Tolerance ±10%; Part GRM21BR61H106KE43L; LCSC C440198
C38, C39: 220nF; C_0805; Voltage Rated 50V; Tolerance ±10%; Part CL21B224KBFNNNE; LCSC C5378
C40: 100nF; C_0805; Voltage Rated 100V; Tolerance ±10%; Part CL21B104KCFNNNE; LCSC C28233
C41, C42, C45, C46, C47, C48: 22uF; C_0805; Voltage Rated 25V; Tolerance ±20%; Part CL21A226MAQNNNE; LCSC C45783
C43: 47pF; C_0402; Voltage Rated 50V; Tolerance ±5%; Part 0402CG470J500NT; LCSC C1567
C44: 4.7nF; C_0402; Voltage Rated 50V; Tolerance ±10%; Part 0402B472K500NT; LCSC C1538
C49, C50: 100uF; CP_Elec_10x10; MPN VZH101M1KTR-1010; LCSC C249838
D1: SMF58CA; D_SOD-123FL; Clamping Voltage 93.6V; Voltage - Breakdown 71.2V; Part SMF58CA; LCSC C42371753
D3, D4: SS510B; D_SMB; Forward Voltage (Vf@If) 0.85V@5.0A; Reverse Voltage (Vr) 100V; Part SS510B; LCSC C7420368
L1: YSPI1050-100M; L_Sunlord_MWSA1005S; LCSC C497897
R21: 47kΩ; R_0402; Overload Voltage (Max) 50V; Tolerance ±1%; Part 0402WGF4702TCE; LCSC C25792
R33, R34: 24.9kΩ; R_0402; Overload Voltage (Max) 50V; Tolerance ±1%; Part 0402WGF2402TCE; LCSC C25874
R37: 8.2kΩ; R_0402; Overload Voltage (Max) 50V; Tolerance ±1%; Part 0402WGF8201TCE; LCSC C25924
R38: 12kΩ; R_0402; Overload Voltage (Max) 50V; Tolerance ±1%; Part 0402WGF1202TCE; LCSC C25752
R39: 240kΩ; R_0603; Overload Voltage (Max) 75V; Tolerance ±1%; Part 0603WAF2403T5E; LCSC C4197
TP16, TP17, TP18, TP19, TP20: TestPoint; TestPoint_Pad_D1.0mm; not fitted
U2: TPS54560BDDA; Texas_R-PDSO-G8_EP2.95x4.9mm_Mask2.4x3.1mm_ThermalVias; LCSC C1850354
U15: AMS1117-3.3; SOT-223-3_TabPin2

Connections:
+3V3: C10.1, C48.1, U15.2 (VO); also elsewhere on the board
+5V: C9.1, C50.1, D4.1, U15.3 (VI); also elsewhere on the board
/VRM/Cap_protec: C30.2, C31.1, C32.2, C33.1, C34.2, C35.1, C38.2, C39.1, R33.2, R34.1
BRD_VIN: C30.1, C32.1, C34.1, C38.1, C49.1, D1.1, R33.1, TP16.1 (1_1), U2.2 (VIN); also elsewhere on the board
GND: C9.2, C10.2, C31.2, C33.2, C35.2, C39.2, C41.2, C42.2, C43.2, C44.2, C45.2, C46.2, C47.2, C48.2, C49.2, C50.2, D1.2, D3.2, R34.2, R37.2, R39.2, U2.7 (GND), U2.9 (GND), U15.1 (GND); also elsewhere on the board
unnamed: C41.1, C42.1, C45.1, C46.1, C47.1, D4.2, L1.2, R21.1, TP19.1 (1_1)
unnamed: C44.1, R38.2
unnamed: C40.2, U2.1 (BOOT)
unnamed: C43.1, R38.1, TP17.1 (1_1), U2.6 (COMP)
unnamed: R21.2, R37.1, TP18.1 (1_1), U2.5 (FB)
unnamed: R39.1, TP20.1 (1_1), U2.4 (RT/CLK)
unnamed: C40.1, D3.1, L1.1, U2.8 (SW)

Notes on the sheet:
saved for kebab on that one alone
INFORMATION
KEEP CRIPPAGE DISTANCE 1.26MM MIN!
~5.4V
Thats not sketch ... thats BOM-bastic!
HUMAN NUMBER GENERATOR OUTPUT
RANDOM NUMBER GENERATOR OUTPUT
~5V
60V MAX
IEC 60664-1 Material Group III (CTI < 400; typical FR-4 = IIIa): 1.25 mm

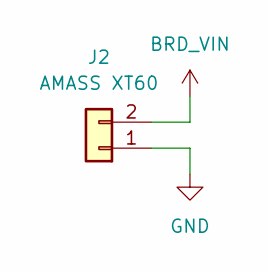
[picture p16: schematic POWER_IN_CONN.kicad_sch, MMS3 MCU ESP32-C6]

Parts:
J2: AMASS XT60; AMASS_XT60PW-M_1x02_P7.20mm_Horizontal; LCSC C98732

Connections:
BRD_VIN: J2.2; also elsewhere on the board
GND: J2.1; also elsewhere on the board

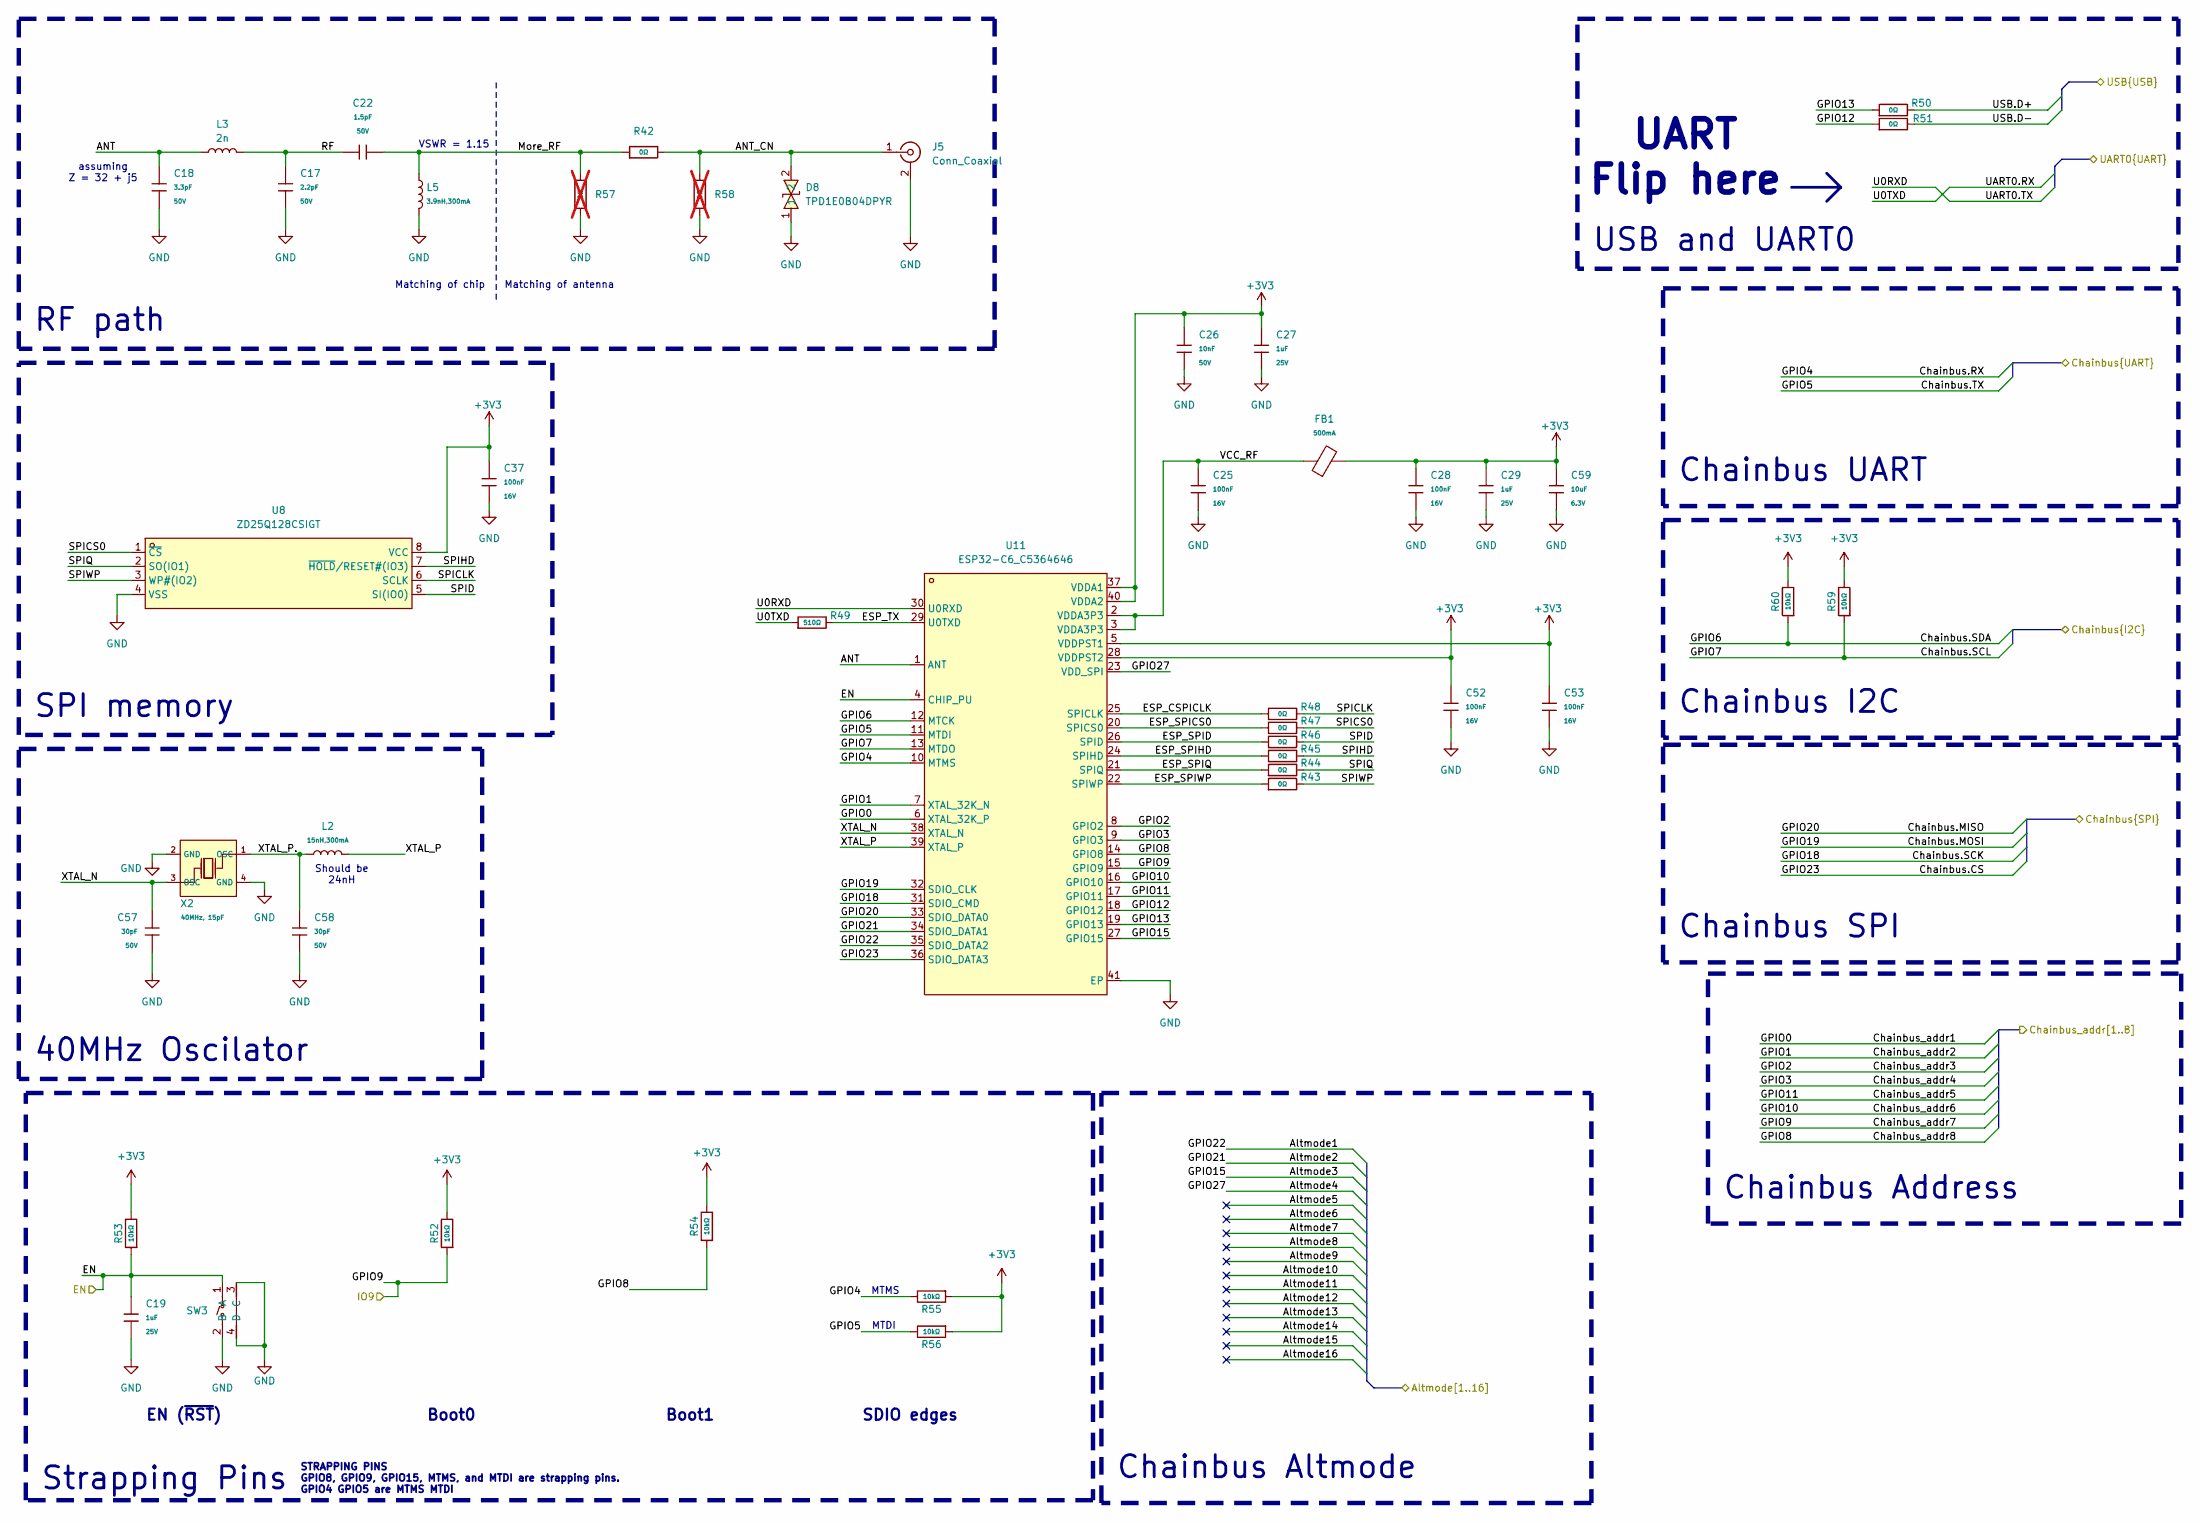
[picture p17: schematic ESP32-C6_chip.kicad_sch]

Parts:
C17: 2.2pF; C_0402; Voltage Rated 50V; Part 0402CG2R2C500NT; LCSC C1559
C18: 3.3pF; C_0402; Voltage Rated 50V; Part 0402CG3R3C500NT; LCSC C1565
C19, C27, C29: 1uF; C_0402; Voltage Rated 25V; Tolerance ±10%; Part CL05A105KA5NQNC; LCSC C52923
C22: 1.5pF; C_0402; Voltage Rated 50V; Part 0402CG1R5C500NT; LCSC C1552
C25, C28, C37, C52, C53: 100nF; C_0402; Voltage Rated 16V; Tolerance ±10%; Part CL05B104KO5NNNC; LCSC C1525
C26: 10nF; C_0402; Voltage Rated 50V; Tolerance ±10%; Part CL05B103KB5NNNC; LCSC C15195
C57, C58: 30pF; C_0402; Voltage Rated 50V; Tolerance ±5%; Part 0402CG300J500NT; LCSC C1570
C59: 10uF; C_0402; Voltage Rated 6.3V; Tolerance ±20%; Part CL05A106MQ5NUNC; LCSC C15525
D8: TPD1E0B04DPYR; X1SON-2_L1.0-W0.6-P0.65-BI; MPN TPD1E0B04DPYR; LCSC Part C1975594
FB1: FB_0805; Current Rating 500mA; Tolerance ±25%; Part GZ2012D601TF; LCSC C1017
J5: Conn_Coaxial; SMA_Amphenol_901-143_Horizontal; LCSC Part C496551
L2: 15nH,300mA; L_0402; Tolerance ±5%; Part SDCL1005C15NJTDF; LCSC C27143
L3: 2n; L_0402; LCSC C2041629
L5: 3.9nH,300mA; L_0402; Part SDCL1005C3N9STDF; LCSC C14033
R42, R43, R44, R45, R46, R47, R48, R50, R51: 0Ω; R_0402; Overload Voltage (Max) 50V; Tolerance ±1%; Part 0402WGF0000TCE; LCSC C17168
R49: 510Ω; R_0402; Overload Voltage (Max) 50V; Tolerance ±1%; Part 0402WGF5100TCE; LCSC C25123
R52, R53, R54, R55, R56, R59, R60: 10kΩ; R_0402; Overload Voltage (Max) 50V; Tolerance ±1%; Part 0402WGF1002TCE; LCSC C25744
R57, R58: 0Ω; R_0402; Overload Voltage (Max) 50V; Tolerance ±1%; Part 0402WGF0000TCE; LCSC C17168; not fitted
SW3: TC-6615Z-12.5-260; SW-TH_4P-L7.3-TC-6615Z-12.5-260; MPN TC-6615Z-12.5-260; LCSC Part C7528758
U8: ZD25Q128CSIGT; SOP-8_L5.3-W5.3-P1.27-LS7.9-BL; MPN ZD25Q128CSIGT; LCSC Part C19626875
U11: ESP32-C6_C5364646; QFN-40_L5.0-W5.0-P0.40-TL-EP3.3; MPN ESP32-C6; LCSC Part C5364646
X2: 40MHz, 15pF; OSC-SMD_4P-L3.2-W2.5-BL_SIT8008BI; PartID X322540MPB4SI; LCSC C9010

Connections:
+3V3: C26.1, C27.1, C28.1, C29.1, C37.1, C52.1, C53.1, C59.1, FB1.2, R52.2, R53.2, R54.2, R55.1, R56.1, R59.2, R60.2, U8.8 (VCC), U11.5 (VDDPST1), U11.28 (VDDPST2), U11.37 (VDDA1), U11.40 (VDDA2); also elsewhere on the board
/ChainBus + ALtmode/Altmode1: U11.35 (SDIO_DATA2); also elsewhere on the board
/ChainBus + ALtmode/Altmode2: U11.34 (SDIO_DATA1); also elsewhere on the board
/ChainBus + ALtmode/Altmode3: U11.27 (GPIO15); also elsewhere on the board
/ChainBus + ALtmode/Altmode4: U11.23 (VDD_SPI); also elsewhere on the board
/ChainBus + ALtmode/Chainbus.CS: U11.36 (SDIO_DATA3); also elsewhere on the board
/ChainBus + ALtmode/Chainbus.MISO: U11.33 (SDIO_DATA0); also elsewhere on the board
/ChainBus + ALtmode/Chainbus.MOSI: U11.32 (SDIO_CLK); also elsewhere on the board
/ChainBus + ALtmode/Chainbus.RX: R55.2, U11.10 (MTMS); also elsewhere on the board
/ChainBus + ALtmode/Chainbus.SCK: U11.31 (SDIO_CMD); also elsewhere on the board
/ChainBus + ALtmode/Chainbus.SCL: R59.1, U11.13 (MTDO); also elsewhere on the board
/ChainBus + ALtmode/Chainbus.SDA: R60.1, U11.12 (MTCK); also elsewhere on the board
/ChainBus + ALtmode/Chainbus.TX: R56.2, U11.11 (MTDI); also elsewhere on the board
/ChainBus + ALtmode/Chainbus_addr1: U11.6 (XTAL_32K_P); also elsewhere on the board
/ChainBus + ALtmode/Chainbus_addr2: U11.7 (XTAL_32K_N); also elsewhere on the board
/ChainBus + ALtmode/Chainbus_addr3: U11.8 (GPIO2); also elsewhere on the board
/ChainBus + ALtmode/Chainbus_addr4: U11.9 (GPIO3); also elsewhere on the board
/ChainBus + ALtmode/Chainbus_addr5: U11.17 (GPIO11); also elsewhere on the board
/ChainBus + ALtmode/Chainbus_addr6: U11.16 (GPIO10); also elsewhere on the board
/ChainBus + ALtmode/Chainbus_addr7: R52.1, U11.15 (GPIO9); also elsewhere on the board
/ChainBus + ALtmode/Chainbus_addr8: R54.1, U11.14 (GPIO8); also elsewhere on the board
/ESP32-C6/ANT: C18.1, L3.1, U11.1 (ANT)
/ESP32-C6/ANT_CN: D8.2, J5.1 (In), R42.2, R58.2
/ESP32-C6/EN: C19.1, R53.1, SW3.1 (A), U11.4 (CHIP_PU); also elsewhere on the board
/ESP32-C6/ESP_CSPICLK: R48.1, U11.25 (SPICLK)
/ESP32-C6/ESP_SPICS0: R47.1, U11.20 (SPICS0)
/ESP32-C6/ESP_SPID: R46.1, U11.26 (SPID)
/ESP32-C6/ESP_SPIHD: R45.1, U11.24 (SPIHD)
/ESP32-C6/ESP_SPIQ: R44.1, U11.21 (SPIQ)
/ESP32-C6/ESP_SPIWP: R43.1, U11.22 (SPIWP)
/ESP32-C6/ESP_TX: R49.2, U11.29 (U0TXD)
/ESP32-C6/GPIO12: R51.1, U11.18 (GPIO12)
/ESP32-C6/GPIO13: R50.1, U11.19 (GPIO13)
/ESP32-C6/More_RF: C22.2, L5.1, R42.1, R57.2
/ESP32-C6/RF: C17.1, C22.1, L3.2
/ESP32-C6/SPICLK: R48.2, U8.6 (SCLK)
/ESP32-C6/SPICS0: R47.2, U8.1 (~CS)
/ESP32-C6/SPID: R46.2, U8.5 (SI(IO0))
/ESP32-C6/SPIHD: R45.2, U8.7 (~HOLD/RESET#(IO3))
/ESP32-C6/SPIQ: R44.2, U8.2 (SO(IO1))
/ESP32-C6/SPIWP: R43.2, U8.3 (WP#(IO2))
/ESP32-C6/UART0.RX: R49.1; also elsewhere on the board
/ESP32-C6/UART0.TX: U11.30 (U0RXD); also elsewhere on the board
/ESP32-C6/USB.D+: R50.2; also elsewhere on the board
/ESP32-C6/USB.D-: R51.2; also elsewhere on the board
/ESP32-C6/VCC_RF: C25.1, FB1.1, U11.2 (VDDA3P3), U11.3 (VDDA3P3)
/ESP32-C6/XTAL_N: C57.1, U11.38 (XTAL_N), X2.3 (OSC)
/ESP32-C6/XTAL_P: L2.2, U11.39 (XTAL_P)
/ESP32-C6/XTAL_P.: C58.1, L2.1, X2.1 (OSC)
GND: C17.2, C18.2, C19.2, C25.2, C26.2, C27.2, C28.2, C29.2, C37.2, C52.2, C53.2, C57.2, C58.2, C59.2, D8.1, J5.2 (Ext), L5.2, R57.1, R58.1, SW3.2 (B), SW3.3 (C), SW3.4 (D), U8.4 (VSS), U11.41 (EP), X2.2 (GND), X2.4 (GND); also elsewhere on the board

Notes on the sheet:
MTDI
Chainbus Altmode
Matching of antenna
Boot0
Chainbus Address
RF path
Should be 24nH
EN (~{RST})
USB and UART0
Matching of chip
Chainbus UART
SDIO edges
Chainbus I2C
VSWR = 1.15
assuming Z = 32 + j5
Chainbus SPI
STRAPPING PINS GPIO8, GPIO9, GPIO15, MTMS, and MTDI are strapping pins. GPIO4 GPIO5 are MTMS MTDI
UART Flip here
40MHz Oscilator
SPI memory
Strapping Pins
MTMS
Boot1

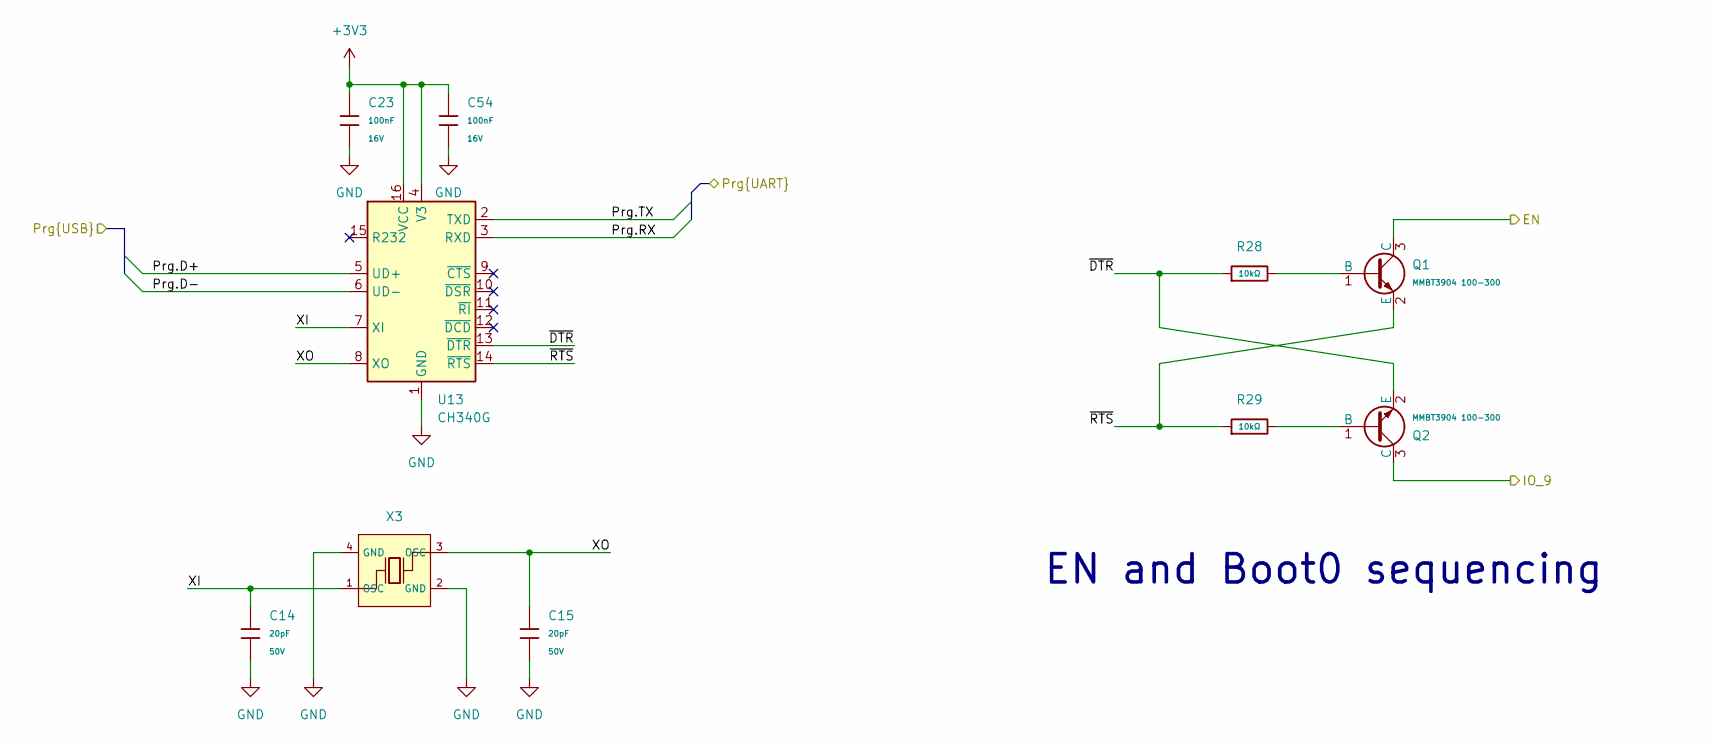
[picture p18: schematic CH340.kicad_sch]

Parts:
C14, C15: 20pF; C_0402; Voltage Rated 50V; Tolerance ±5%; Part 0402CG200J500NT; LCSC C1554
C23, C54: 100nF; C_0402; Voltage Rated 16V; Tolerance ±10%; Part CL05B104KO5NNNC; LCSC C1525
Q1, Q2: MMBT3904 100-300; Q_SOT-23; Part MMBT3904(RANGE:100-300); LCSC C20526
R28, R29: 10kΩ; R_0402; Overload Voltage (Max) 50V; Tolerance ±1%; Part 0402WGF1002TCE; LCSC C25744
U13: CH340G; SOIC-16_3.9x9.9mm_P1.27mm; LCSC C14267
X3: X322512MSB4SI; CRYSTAL-SMD_4P-L3.2-W2.5-BL; Frequency Tolerance ±10ppm; Part X322512MSB4SI; LCSC C9002

Connections:
+3V3: C23.1, C54.1, U13.4 (V3), U13.16 (VCC); also elsewhere on the board
/ChainBus + ALtmode/Chainbus_addr7: Q2.3 (C); also elsewhere on the board
/ESP32-C6/EN: Q1.3 (C); also elsewhere on the board
/ESP32-C6/UART0.RX: U13.3 (RXD); also elsewhere on the board
/ESP32-C6/UART0.TX: U13.2 (TXD); also elsewhere on the board
/UART_Programmer/Prg.D+: U13.5 (UD+); also elsewhere on the board
/UART_Programmer/Prg.D-: U13.6 (UD-); also elsewhere on the board
/UART_Programmer/XI: C14.1, U13.7 (XI), X3.1 (OSC)
/UART_Programmer/XO: C15.1, U13.8 (XO), X3.3 (OSC)
/UART_Programmer/~DTR: Q2.2 (E), R28.1, U13.13 (~DTR)
/UART_Programmer/~RTS: Q1.2 (E), R29.1, U13.14 (~RTS)
GND: C14.2, C15.2, C23.2, C54.2, U13.1 (GND), X3.2 (GND), X3.4 (GND); also elsewhere on the board
unnamed: Q1.1 (B), R28.2
unnamed: Q2.1 (B), R29.2

Notes on the sheet:
EN and Boot0 sequencing

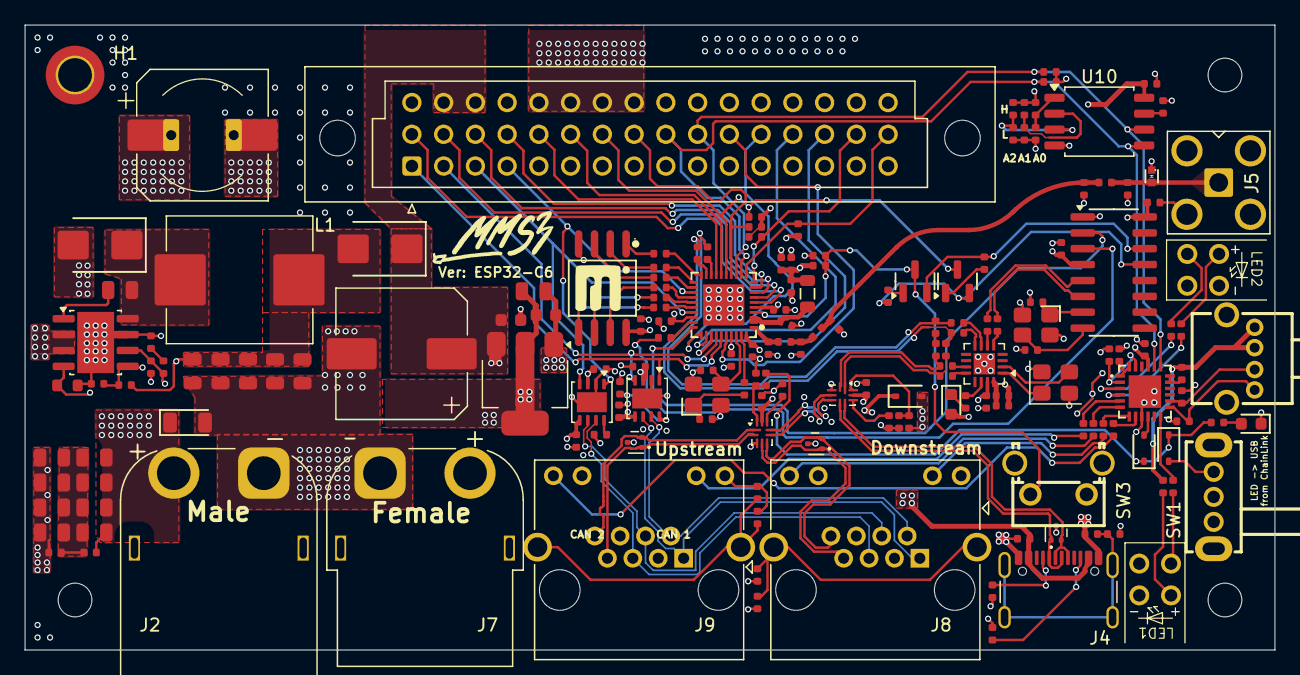
[picture p19: board MMS3_ESP32-C6.kicad_pcb from above]

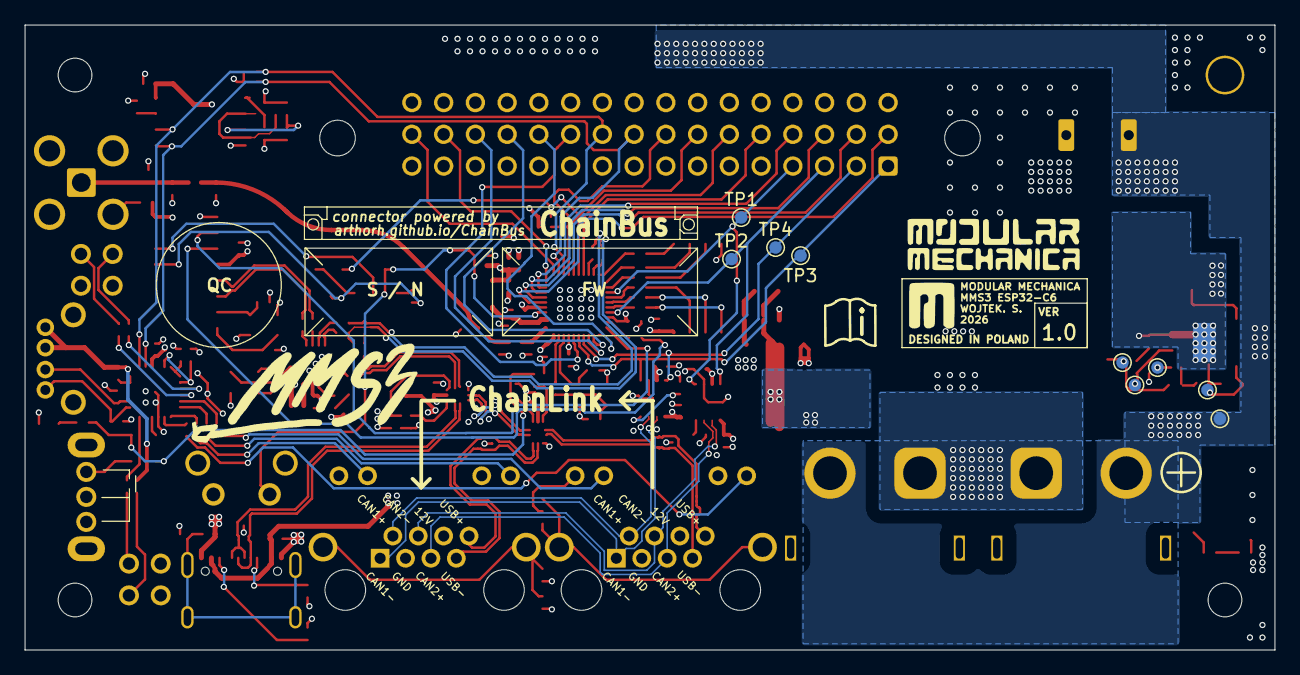
[picture p20: board MMS3_ESP32-C6.kicad_pcb from below]

Board: 4 copper layers, 100.0 x 50.0 mm, 185 parts (9 on the bottom side), 135 nets.
