I-want-to-make-more-forks-of-same-repo/MMS3_MCU_ESP32-C6/(commit log)

2026-07-20 finished routing
    [BOM.csv, CAN_TR.kicad_sch, Chainbus-Pinout-F405-MMS3.xlsx, I2C_Flash.kicad_sch, Interboard_connector.kicad_sch, MCU.kicad_sch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]
2026-07-28 temp commit
    [CAN_TR.kicad_sch, CH32V003.kicad_sch, CH340.kicad_sch, ESP32-C6_chip.kicad_sch, I2C_Flash.kicad_sch, IO.kicad_sch, Interboard_connector.kicad_sch, MCU.kicad_sch]
2026-08-02 backup commit
    [CH32V003.kicad_sch, CH340.kicad_sch, ESP32-C6_chip.kicad_sch, I2C_Flash.kicad_sch, IO.kicad_sch, MMS3_ESP32-C6.kicad_pcb, MMS3_ESP32-C6.kicad_sch, USBC_CONN.kicad_sch]
2026-08-04 working commit
    [ESP32-C6_chip.kicad_sch, MMS3_ESP32-C6.kicad_pcb, MMS3_ESP32-C6.kicad_sch]
2026-08-06 initial routing done
    [CH32V003.kicad_sch, ESP32-C6_chip.kicad_sch, IO.kicad_sch, MMS3_ESP32-C6.kicad_pcb, MMS3_ESP32-C6.kicad_sch, USB HUB.kicad_sch]
2026-08-08 routing done
    [ESP32-C6_MMS_Wrapper.kicad_sch, ESP32-C6_chip.kicad_sch, MMS3_ESP32-C6.kicad_pcb, MMS3_ESP32-C6.kicad_sch]
2026-08-18 generated BAD production files
    [BOM-MMS3_ESP32-C6.csv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]
2026-10-01 eem, done?
    [BOM-MMS3_ESP32-C6.csv, CAN_TR.kicad_sch, CH32V003.kicad_sch, CH340.kicad_sch, ESP32-C6_MMS_Wrapper.kicad_sch, ESP32-C6_chip.kicad_sch, I2C_Flash.kicad_sch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]
2026-10-01 fixed bom problem, still 1.0
    [CPL-MMS3_ESP32-C6.csv, MMS3_ESP32-C6-CuBottom.gbr, MMS3_ESP32-C6-CuIn1.gbr, MMS3_ESP32-C6-CuIn2.gbr, MMS3_ESP32-C6-CuTop.gbr, MMS3_ESP32-C6-EdgeCuts.gbr, MMS3_ESP32-C6-MaskBottom.gbr, MMS3_ESP32-C6-MaskTop.gbr]
2026-10-02 fixed swapped RX/TX & D+/D_
    [BOM-MMS3_ESP32-C6.csv, CH340.kicad_sch, ESP32-C6_MMS_Wrapper.kicad_sch, ESP32-C6_chip.kicad_sch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]
